MIT-HandHeldMRI/HandHeldMRI/README.md

# 64800_MRI
Designs for the 3D printed tabletop MRI for 6.4800: Biomedical Imaging with MRI

<p align="center">
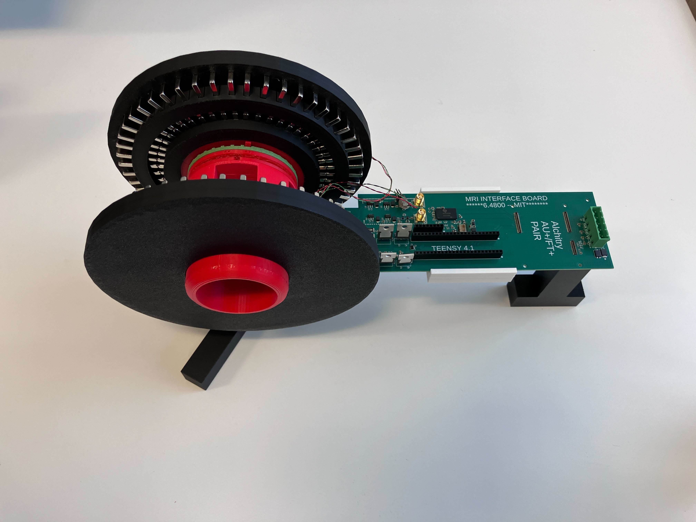
[picture p1: Images/Assembly Video/IMG_1327.jpg]
An image of an assembled MRI system
    
</p>
