MIT-HandHeldMRI/HandHeldMRI/Visualizer/vis/Uploads/d6a883e2-0e5f-45bc-9a12-a8bf46f9005b_whisk.png

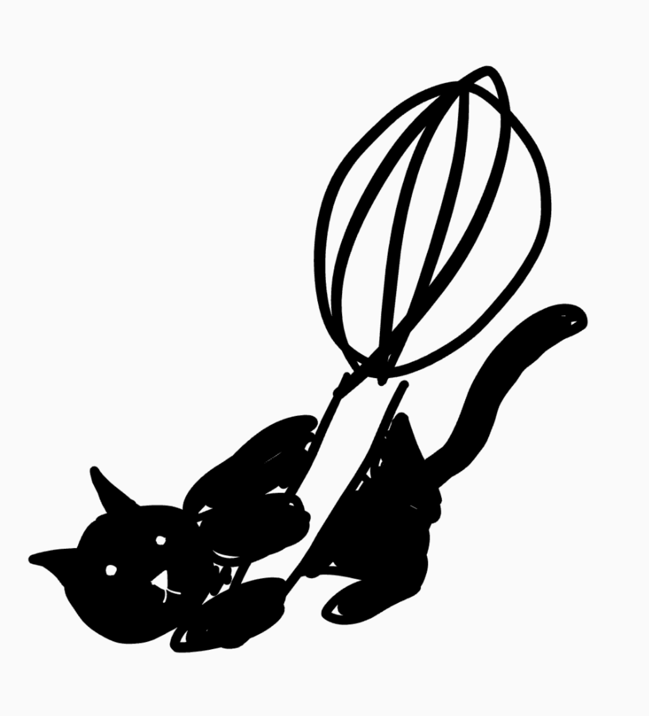
Visualizer/vis/Uploads/d6a883e2-0e5f-45bc-9a12-a8bf46f9005b_whisk.png
