MIT-HandHeldMRI/HandHeldMRI/Magnet_stl1126/mri25StandPeg.stl

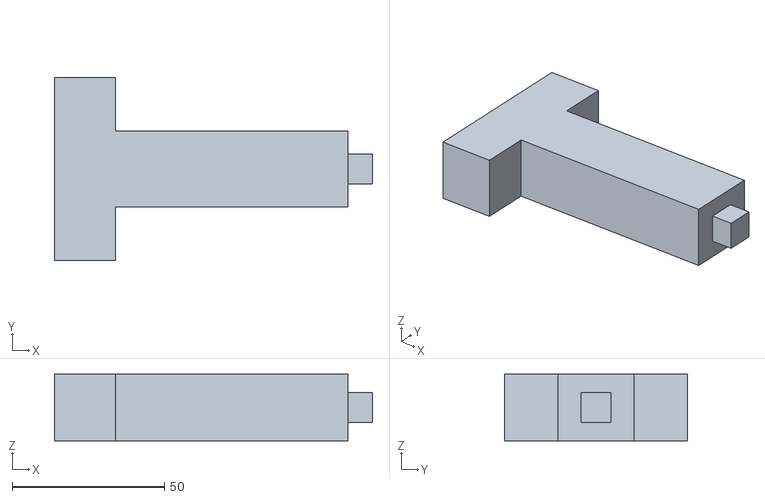
[picture p3: CAD file, 2026-11-03]
Magnet_stl1126/mri25StandPeg.stl
104.5 x 60.0 x 22.0
