MIT-HandHeldMRI/HandHeldMRI/Magnet_stl1126/mri25Cam3p28w.stl

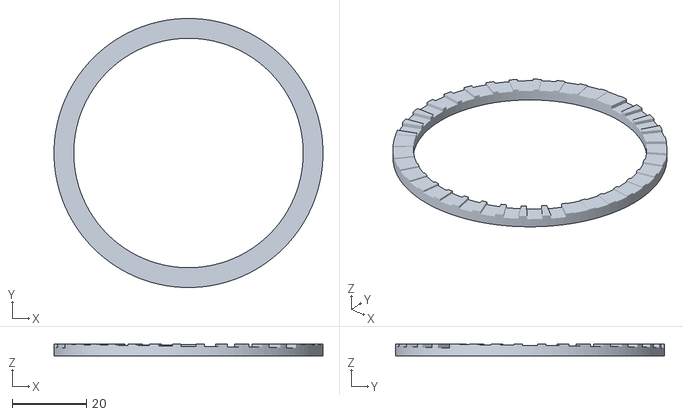
[picture p4: CAD file, 2026-11-03]
Magnet_stl1126/mri25Cam3p28w.stl
72.5 x 72.5 x 3.28
