MIT-HandHeldMRI/HandHeldMRI/Magnet_stl1126/threeSlit.stl

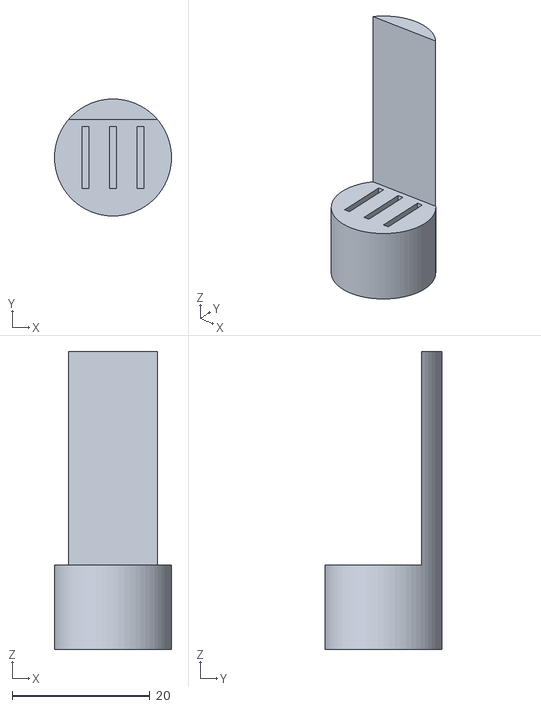
[picture p6: CAD file, 2026-11-03]
Magnet_stl1126/threeSlit.stl
17.0 x 17.0 x 43.3
