MIT-HandHeldMRI/HandHeldMRI/Magnet_stl1126/coneMRIxy.stl

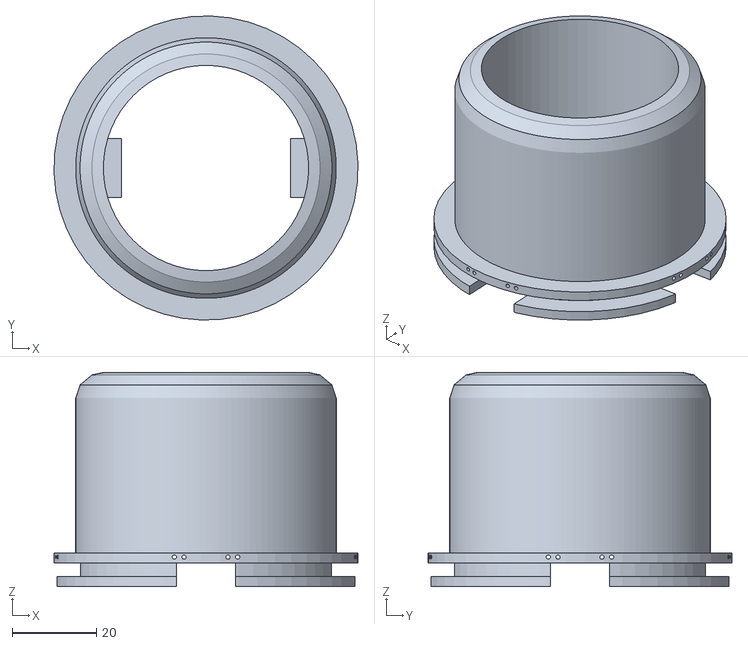
[picture p7: CAD file, 2026-11-03]
Magnet_stl1126/coneMRIxy.stl
72.0 x 72.0 x 50.7
