MIT-HandHeldMRI/HandHeldMRI/Magnet_stl1126/standxy.stl

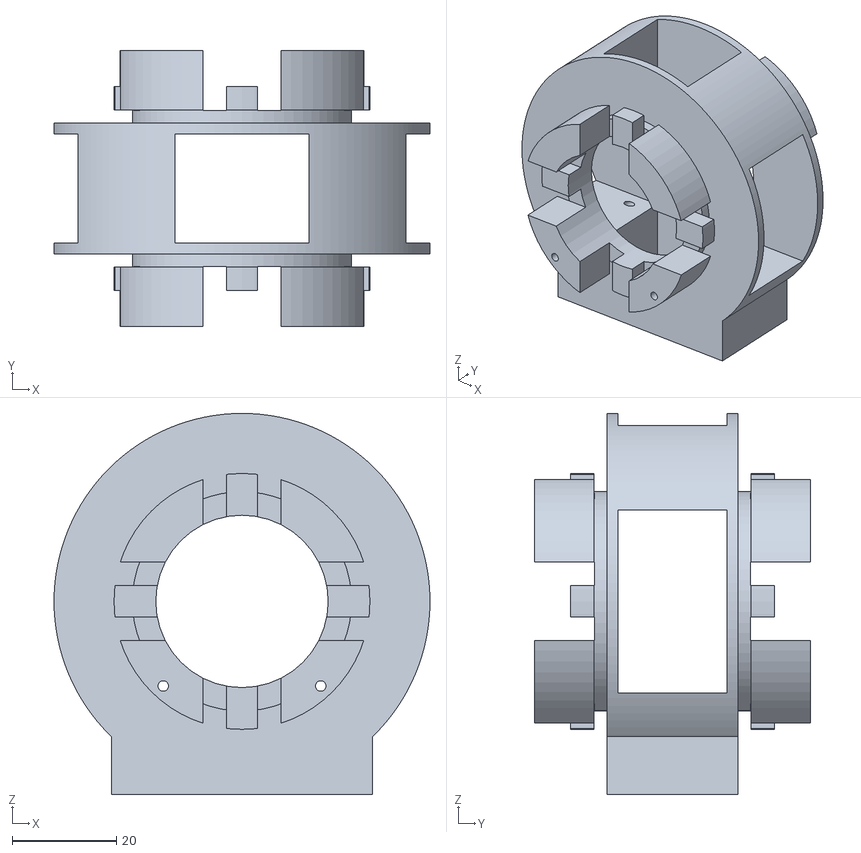
[picture p8: CAD file, 2026-11-03]
Magnet_stl1126/standxy.stl
72.0 x 52.9 x 73.0
