MIT-HandHeldMRI/HandHeldMRI/Magnet_stl1126/space17p5.stl

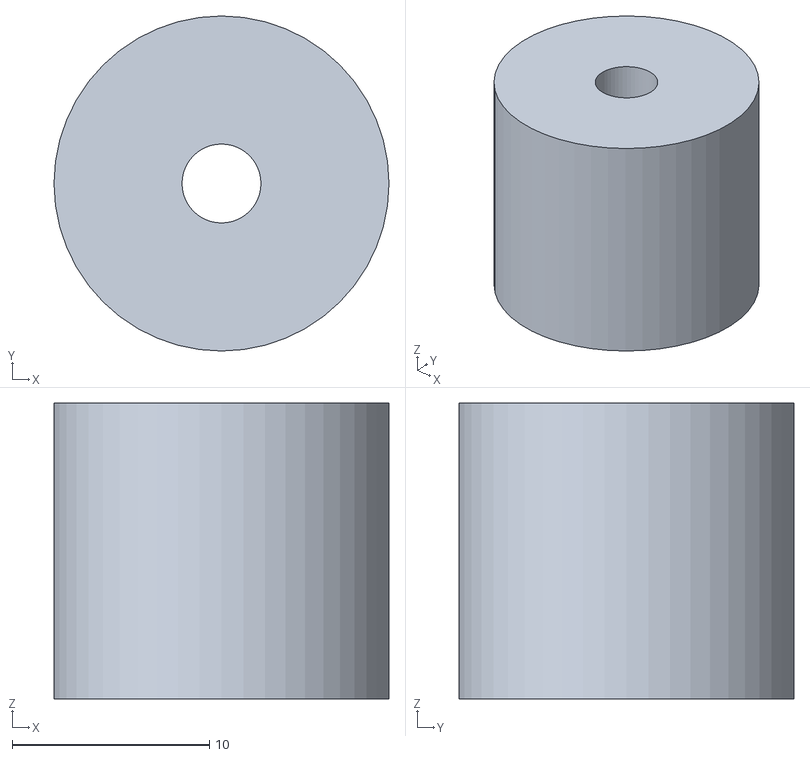
[picture p9: CAD file, 2026-11-03]
Magnet_stl1126/space17p5.stl
17.0 x 17.0 x 15.0
