MIT-HandHeldMRI/HandHeldMRI/Magnet_stl1126/mri25Cam4p22w.stl

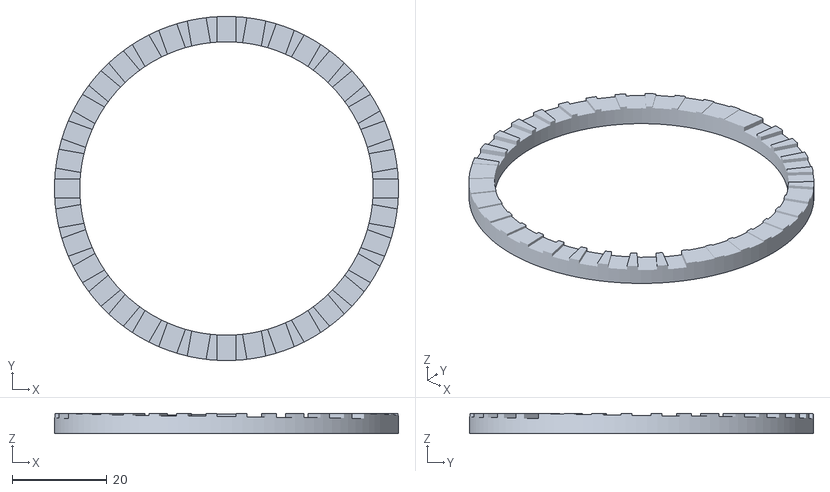
[picture p10: CAD file, 2026-11-03]
Magnet_stl1126/mri25Cam4p22w.stl
72.5 x 72.5 x 4.22
