MIT-HandHeldMRI/HandHeldMRI/Magnet_stl1126/mri25MagRing.stl

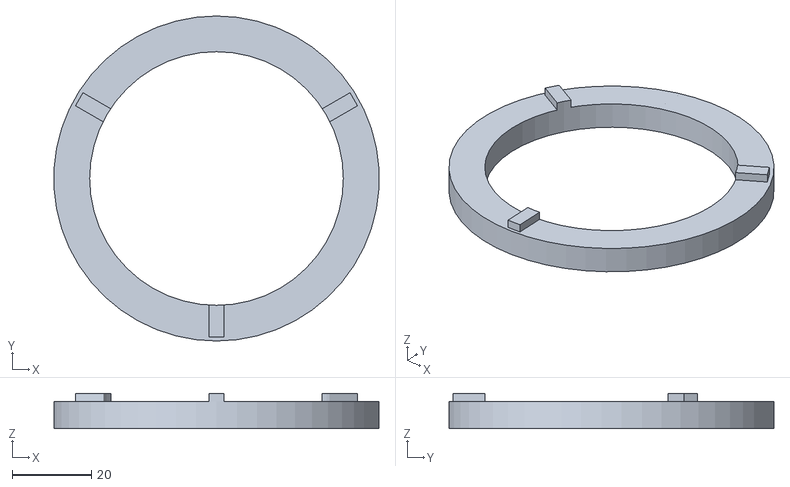
[picture p11: CAD file, 2026-11-03]
Magnet_stl1126/mri25MagRing.stl
82.0 x 82.0 x 8.90
