MIT-HandHeldMRI/HandHeldMRI/Magnet_stl1126/mri25_10x10x10.stl

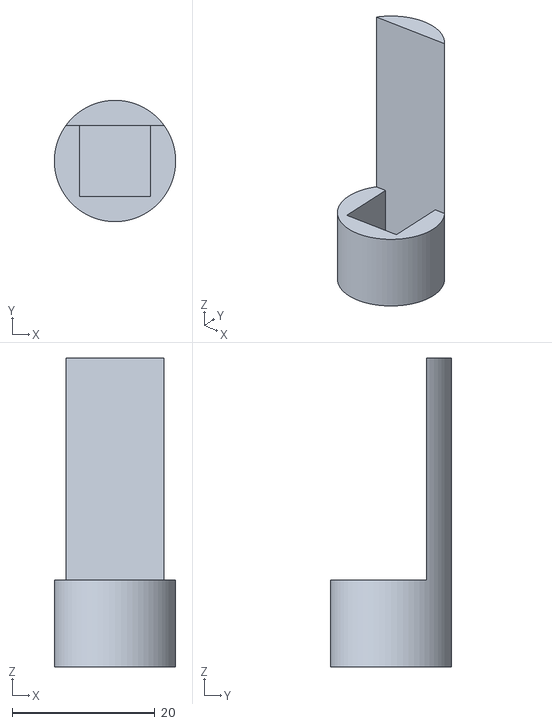
[picture p12: CAD file, 2026-11-03]
Magnet_stl1126/mri25_10x10x10.stl
17.0 x 17.0 x 43.3
