MIT-HandHeldMRI/HandHeldMRI/Magnet_stl1126/mri26SupportPlate.stl

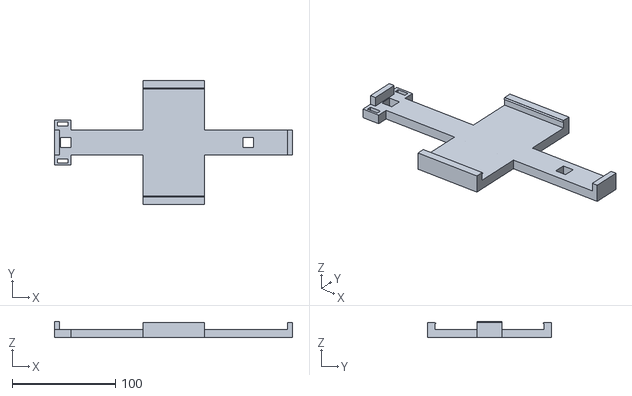
[picture p13: CAD file, 2026-11-03]
Magnet_stl1126/mri26SupportPlate.stl
231.0 x 120.0 x 16.0
