MIT-HandHeldMRI/HandHeldMRI/Magnet_stl1126/mri25threeSlice.stl

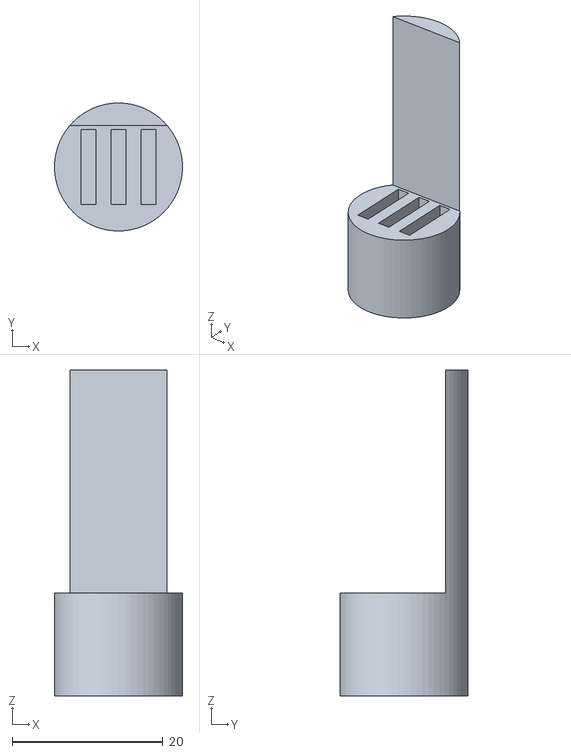
[picture p14: CAD file, 2026-11-03]
Magnet_stl1126/mri25threeSlice.stl
17.0 x 17.0 x 43.3
