MIT-HandHeldMRI/HandHeldMRI/Magnet_stl1126/mri25RfCoilForm.stl

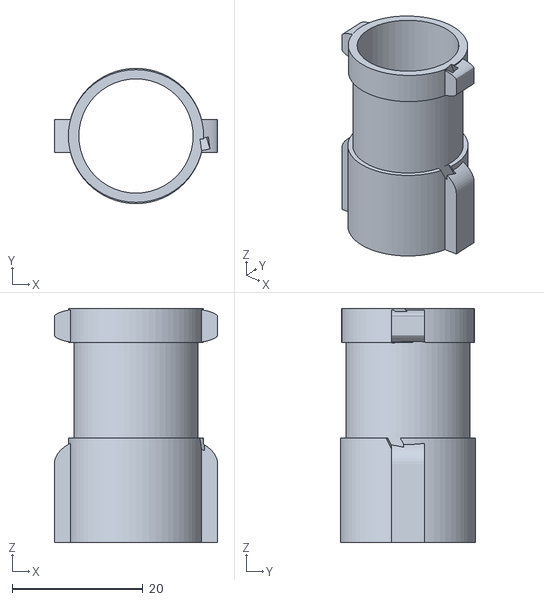
[picture p15: CAD file, 2026-11-03]
Magnet_stl1126/mri25RfCoilForm.stl
25.0 x 20.7 x 35.8
