MIT-HandHeldMRI/HandHeldMRI/Magnet_stl1126/pusher.stl

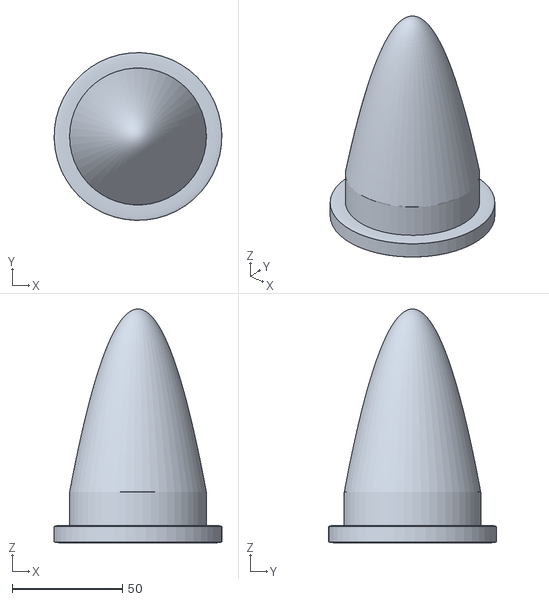
[picture p16: CAD file, 2026-11-03]
Magnet_stl1126/pusher.stl
76.0 x 76.0 x 106.0
