MIT-HandHeldMRI/HandHeldMRI/Magnet_stl1126/mri25Stand.stl

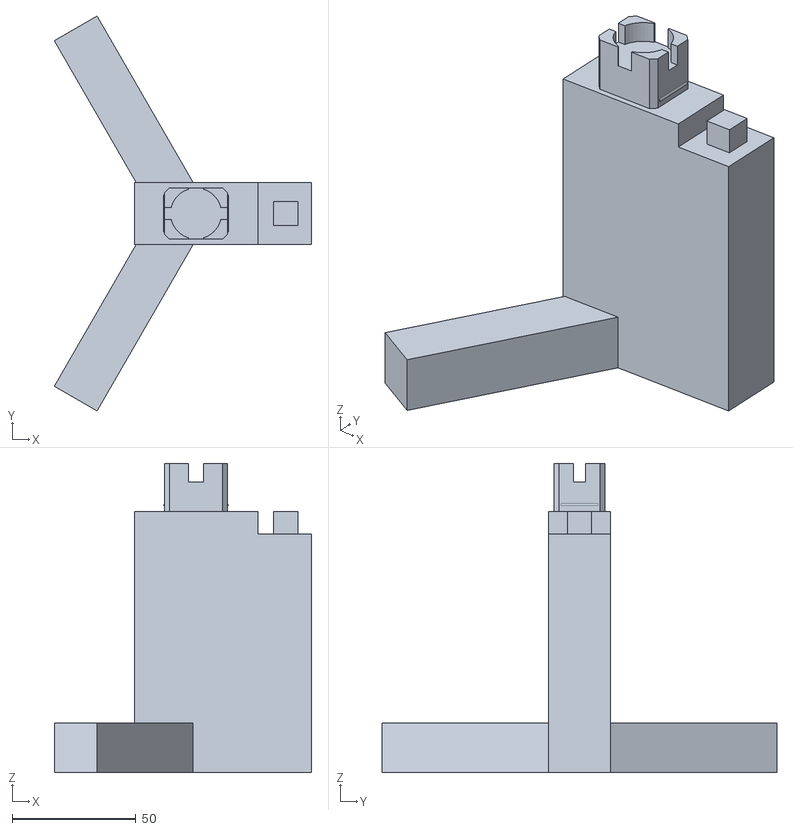
[picture p17: CAD file, 2026-11-03]
Magnet_stl1126/mri25Stand.stl
104.2 x 159.9 x 125.1
