MIT-HandHeldMRI/HandHeldMRI/Magnet_stl1126/mri25Spacer.stl

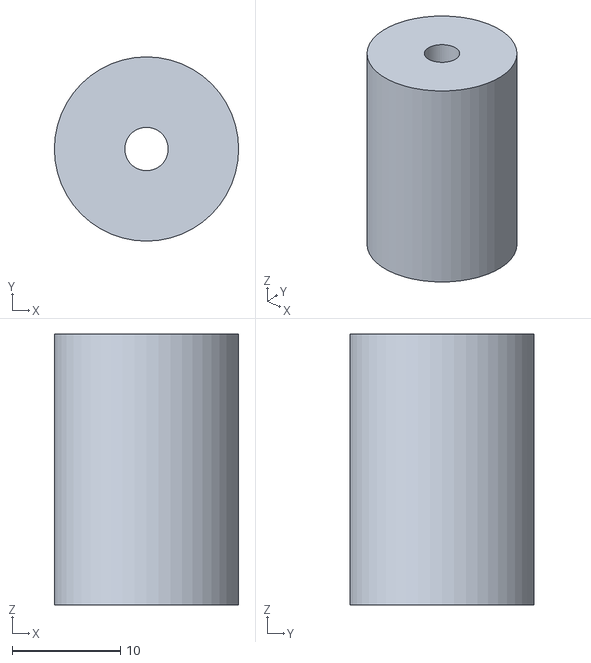
[picture p18: CAD file, 2026-11-03]
Magnet_stl1126/mri25Spacer.stl
17.0 x 17.0 x 25.0
