MIT-HandHeldMRI/HandHeldMRI/Magnet_stl1126/magRing.stl

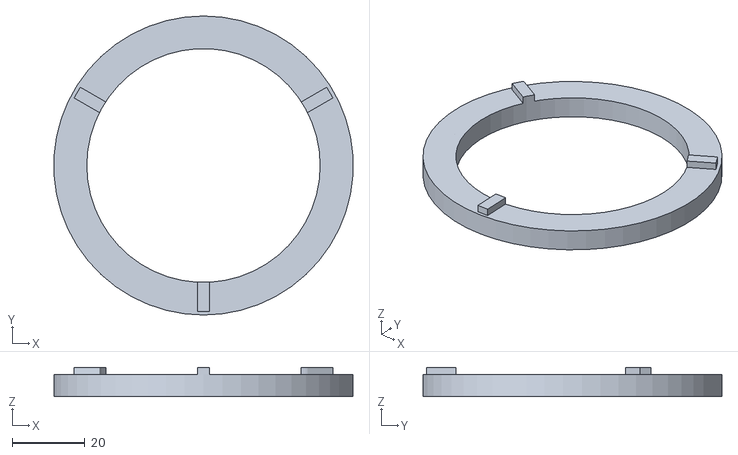
[picture p19: CAD file, 2026-11-03]
Magnet_stl1126/magRing.stl
82.0 x 82.0 x 8.00
