MIT-HandHeldMRI/HandHeldMRI/Magnet_stl1126/mri25MagHolder.stl

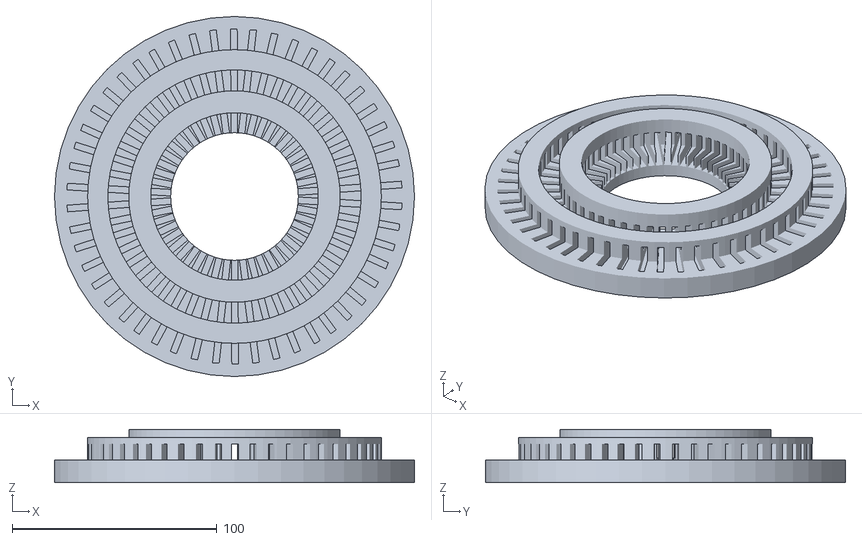
[picture p20: CAD file, 2026-11-03]
Magnet_stl1126/mri25MagHolder.stl
176.0 x 176.0 x 26.0
