MIT-HandHeldMRI/HandHeldMRI/Magnet_stl1126/mri25cam3p6.stl

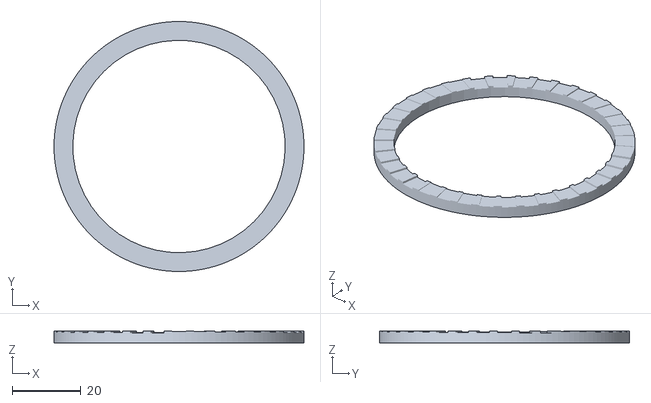
[picture p21: CAD file, 2026-11-03]
Magnet_stl1126/mri25cam3p6.stl
72.8 x 72.8 x 3.60
