MIT-HandHeldMRI/HandHeldMRI/(list of files, cad)

Other CAD files:
Images/Assembly Video/assembly.blend
