MIT-HandHeldMRI/HandHeldMRI/Images/Assembly Video/IMG_1287.jpg

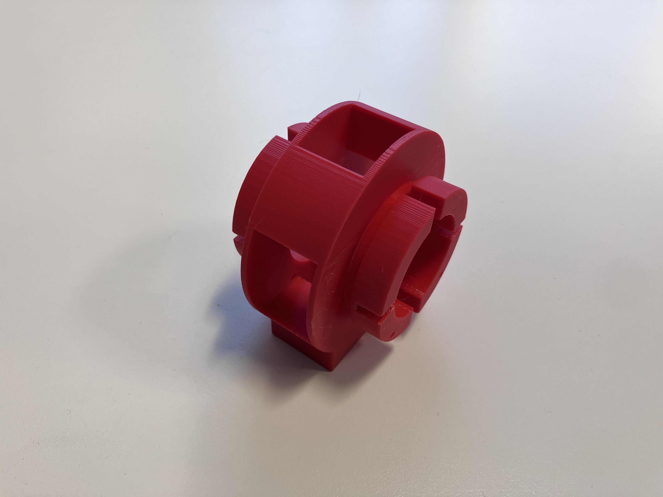
Images/Assembly Video/IMG_1287.jpg
