MIT-HandHeldMRI/HandHeldMRI/Images/Assembly Video/IMG_1288.jpg

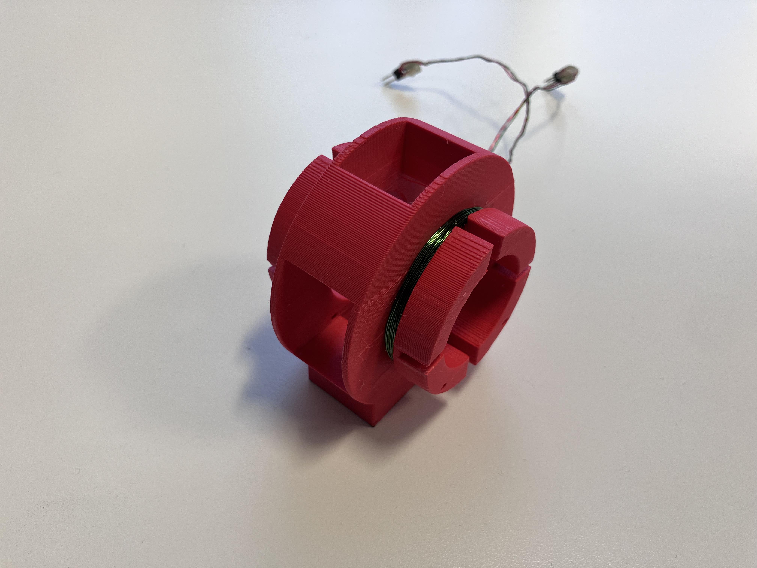
Images/Assembly Video/IMG_1288.jpg
