MIT-HandHeldMRI/HandHeldMRI/Images/Assembly Video/IMG_1291.jpg

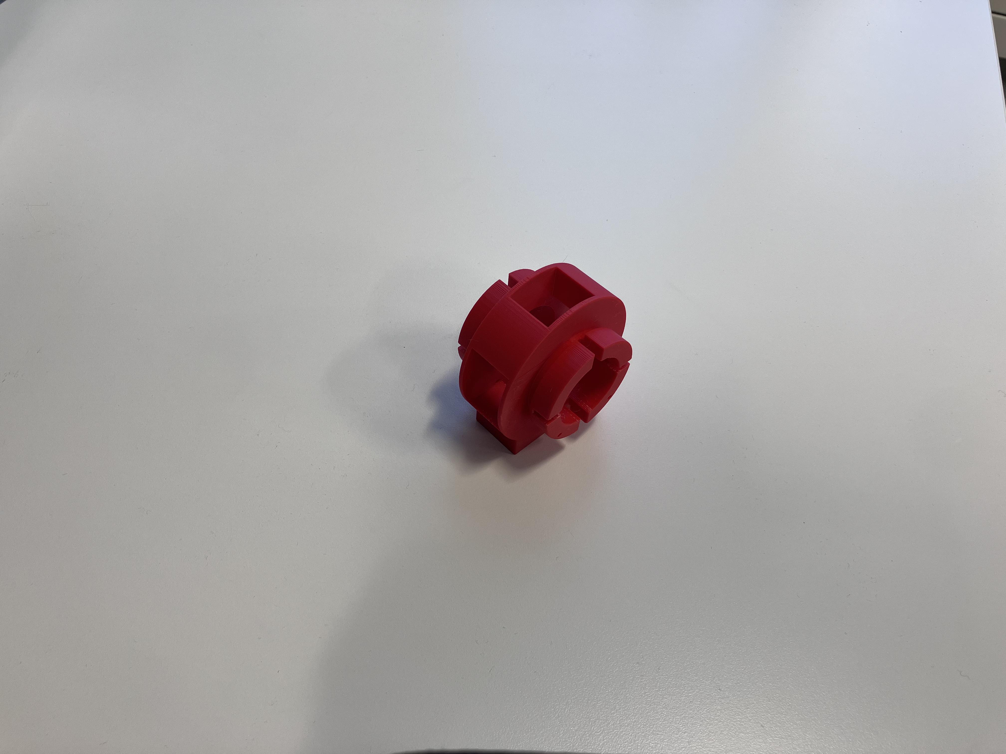
Images/Assembly Video/IMG_1291.jpg
