MIT-HandHeldMRI/HandHeldMRI/Images/Assembly Video/IMG_1292.jpg

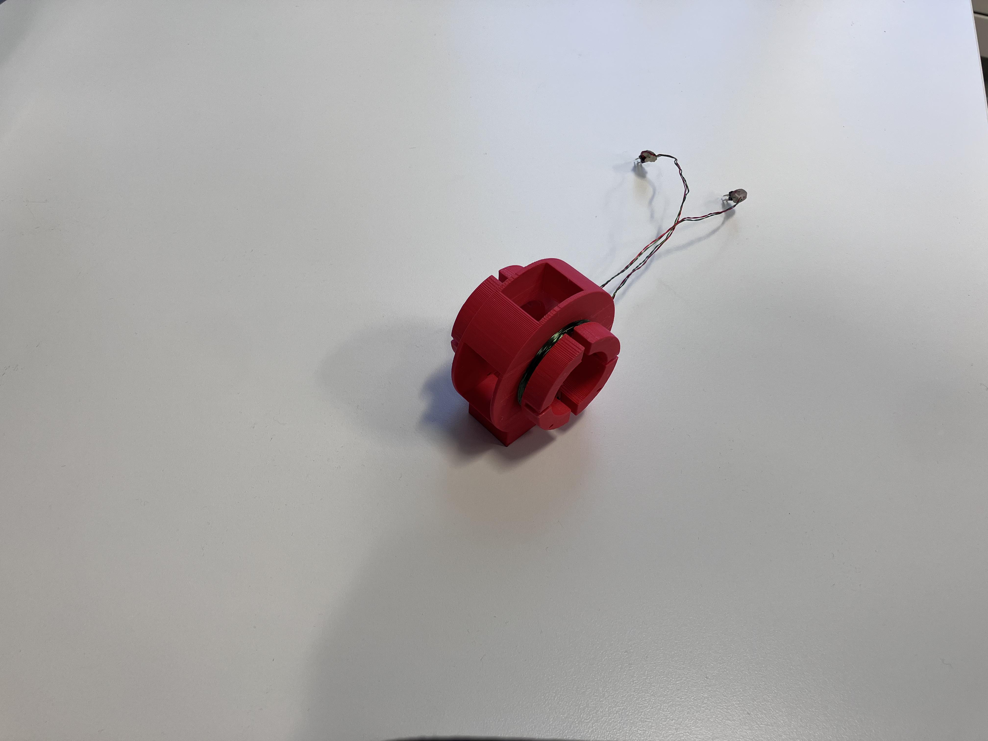
Images/Assembly Video/IMG_1292.jpg
