MIT-HandHeldMRI/HandHeldMRI/Images/Assembly Video/IMG_1293.jpg

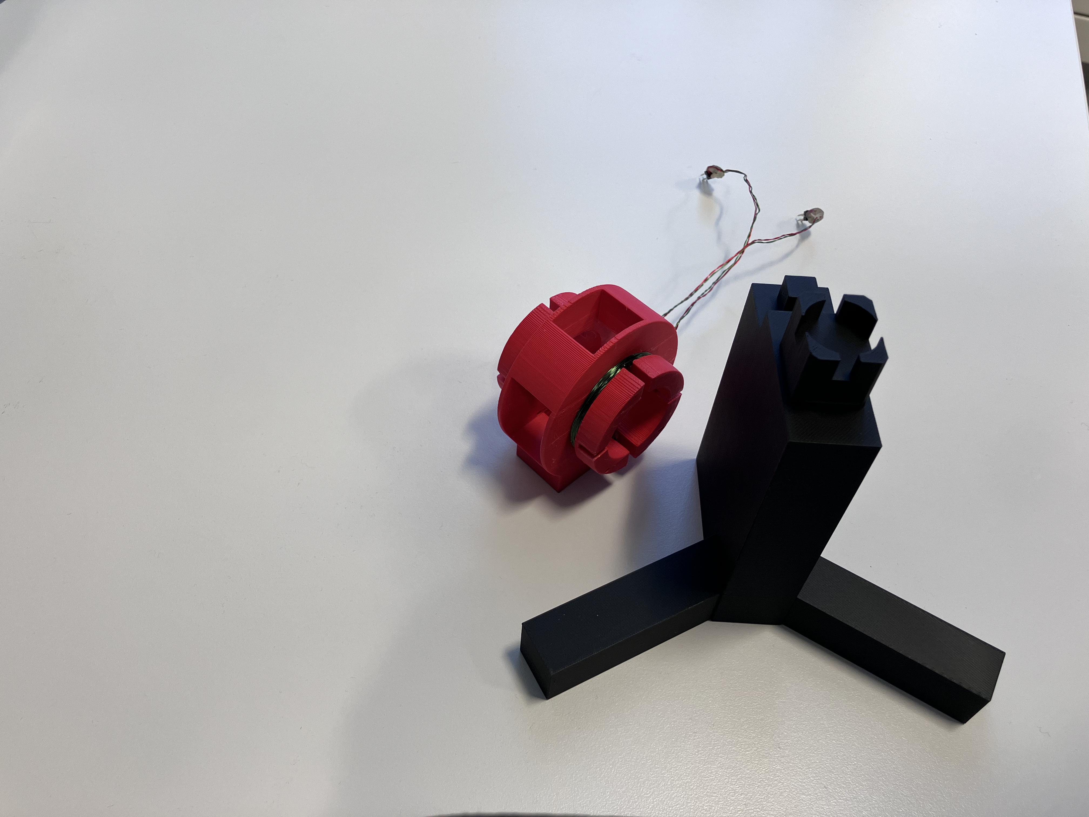
Images/Assembly Video/IMG_1293.jpg
