MIT-HandHeldMRI/HandHeldMRI/Images/Assembly Video/IMG_1294.jpg

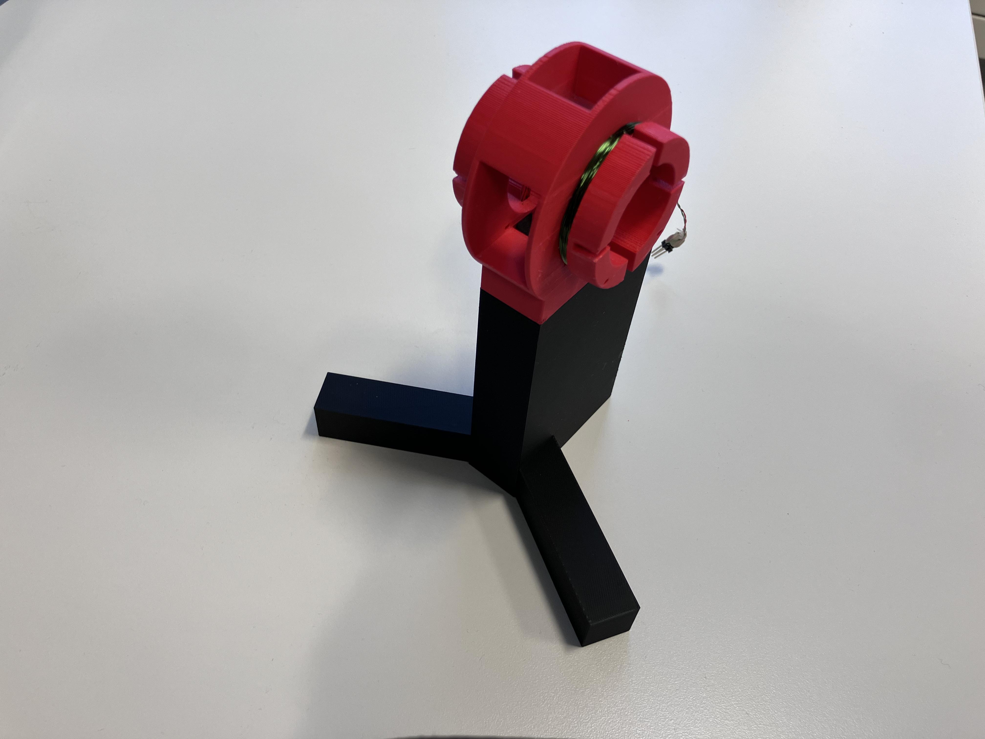
Images/Assembly Video/IMG_1294.jpg
