MIT-HandHeldMRI/HandHeldMRI/Images/Assembly Video/IMG_1295.jpg

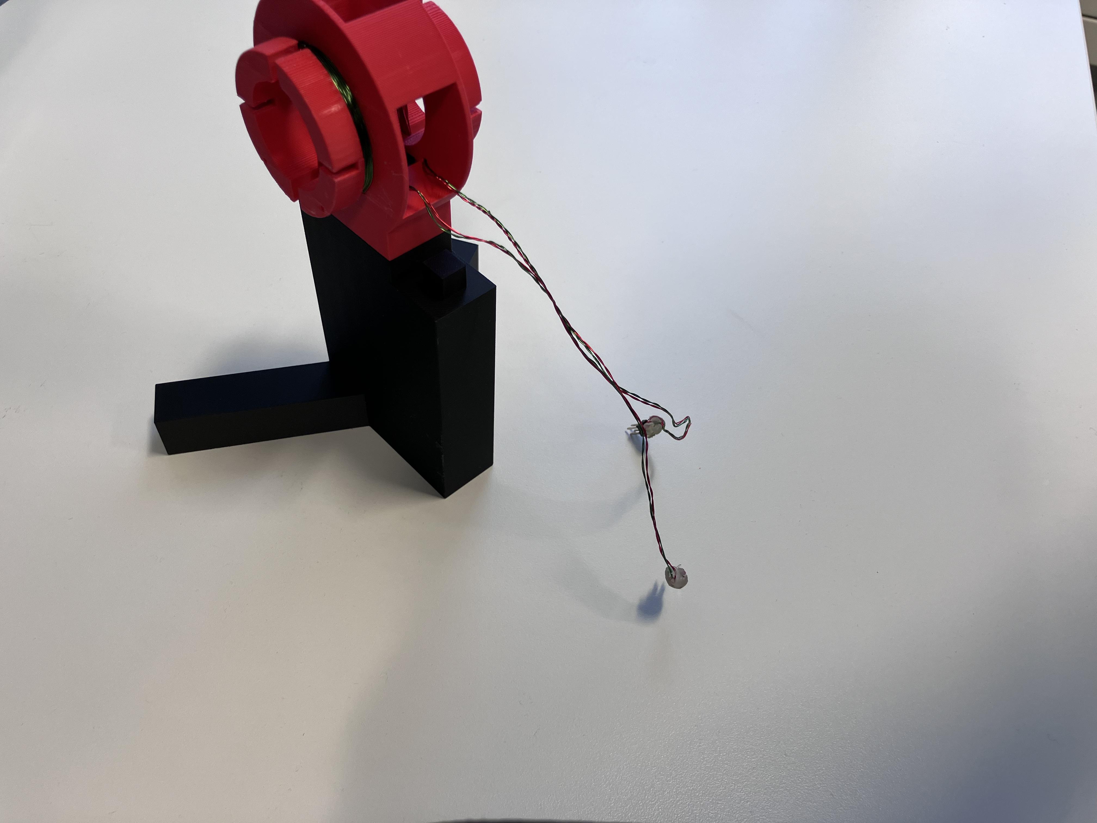
Images/Assembly Video/IMG_1295.jpg
