MIT-HandHeldMRI/HandHeldMRI/Images/Assembly Video/IMG_1296.jpg

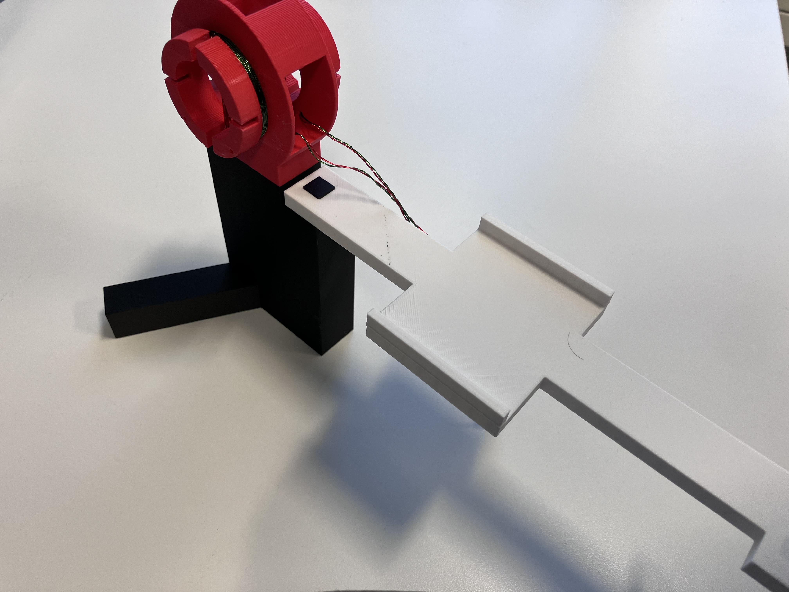
Images/Assembly Video/IMG_1296.jpg
