MIT-HandHeldMRI/HandHeldMRI/Images/Assembly Video/IMG_1297.jpg

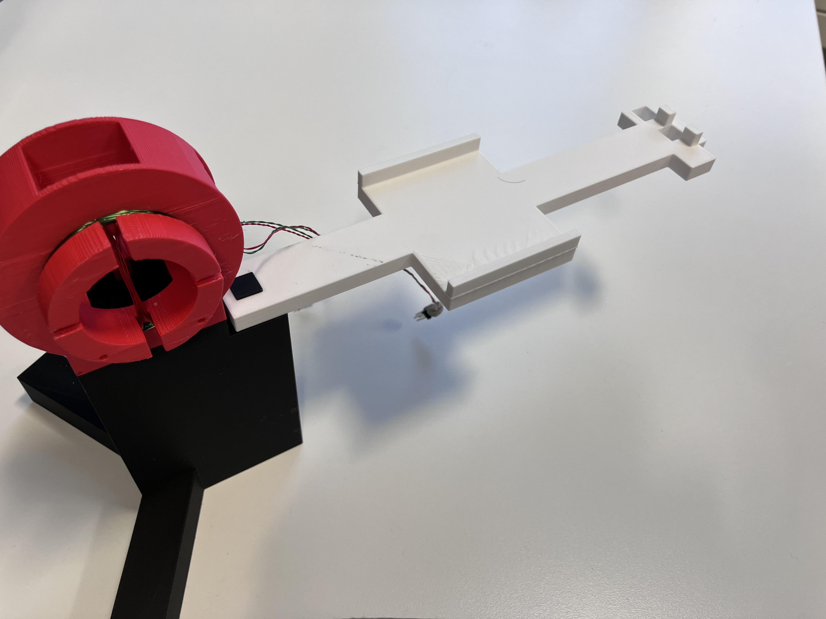
Images/Assembly Video/IMG_1297.jpg
