MIT-HandHeldMRI/HandHeldMRI/Images/Assembly Video/IMG_1298.jpg

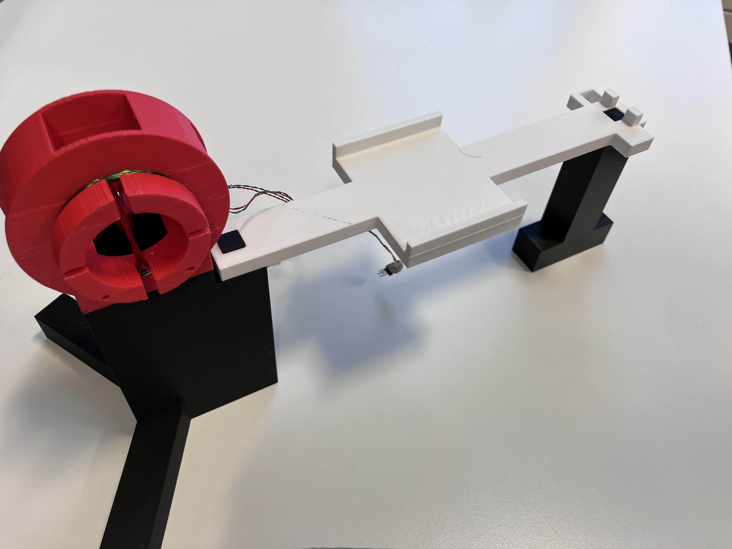
Images/Assembly Video/IMG_1298.jpg
