MIT-HandHeldMRI/HandHeldMRI/Images/Assembly Video/IMG_1299.jpg

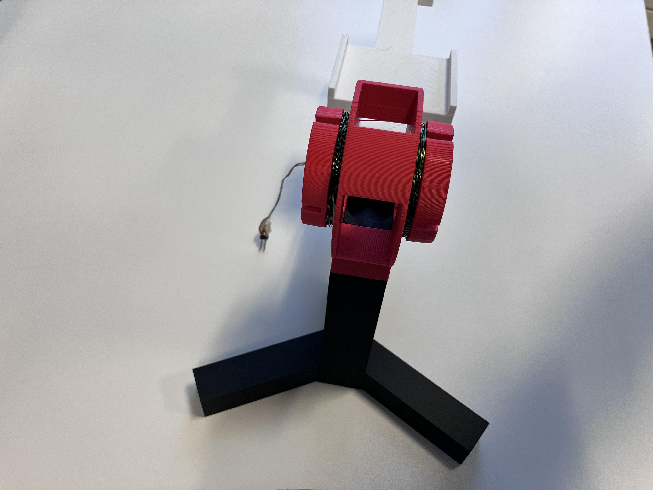
Images/Assembly Video/IMG_1299.jpg
