MIT-HandHeldMRI/HandHeldMRI/Images/Assembly Video/IMG_1300.jpg

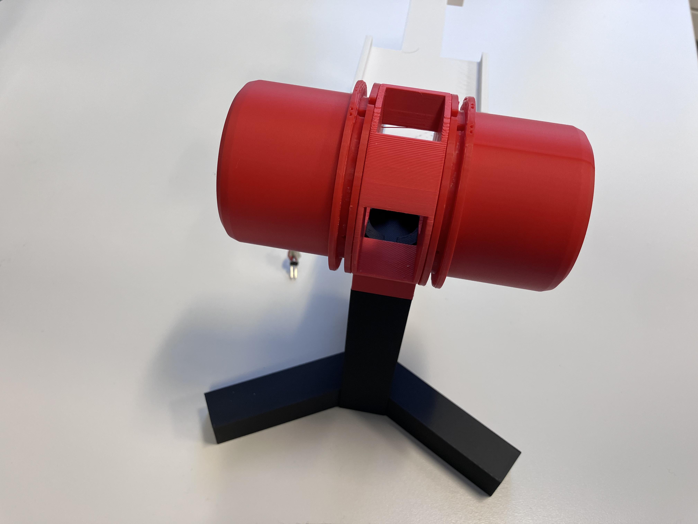
Images/Assembly Video/IMG_1300.jpg
