MIT-HandHeldMRI/HandHeldMRI/Images/Assembly Video/IMG_1301.jpg

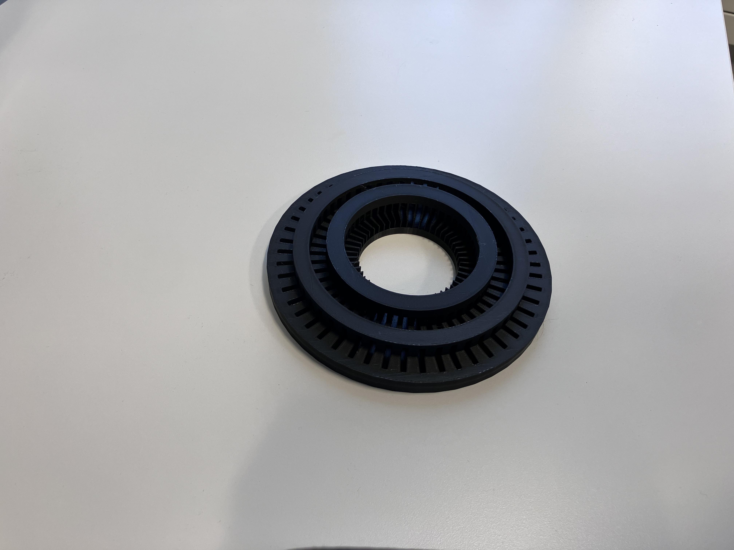
Images/Assembly Video/IMG_1301.jpg
