MIT-HandHeldMRI/HandHeldMRI/Images/Assembly Video/IMG_1303.jpg

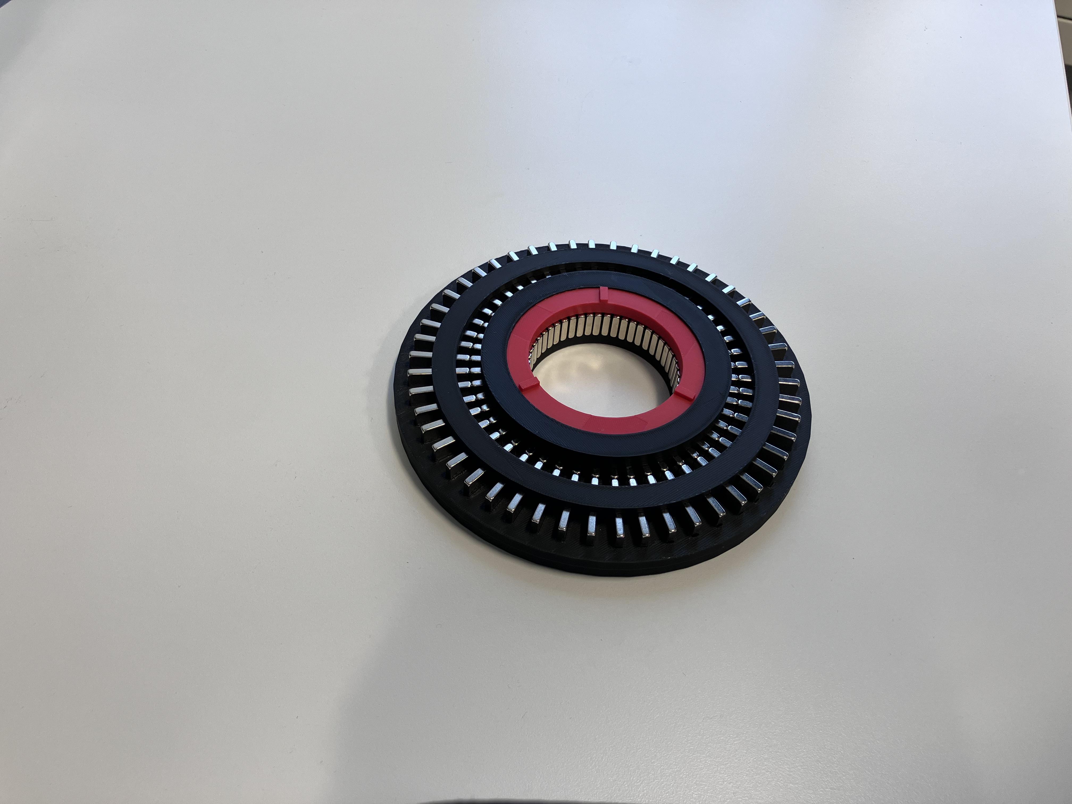
Images/Assembly Video/IMG_1303.jpg
