MIT-HandHeldMRI/HandHeldMRI/Images/Assembly Video/IMG_1304.jpg

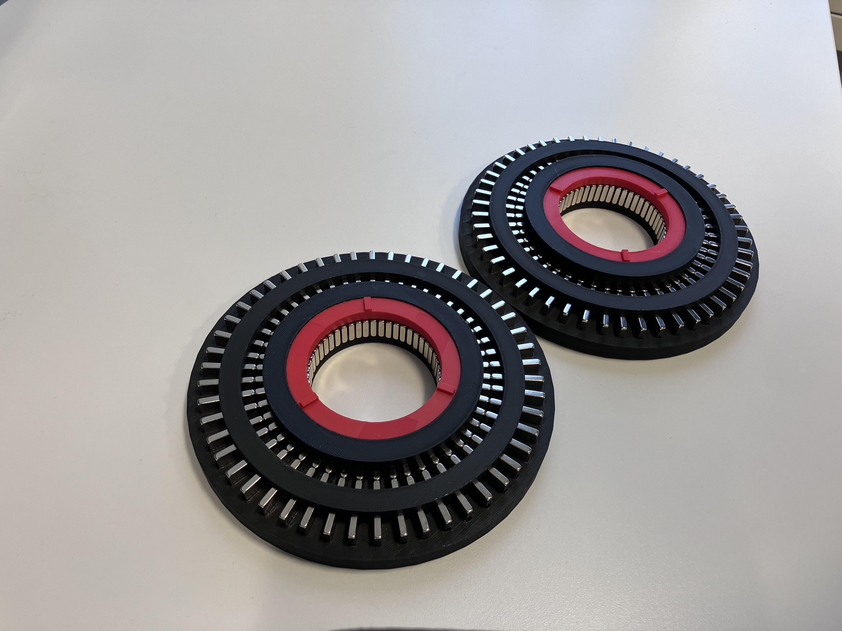
Images/Assembly Video/IMG_1304.jpg
