MIT-HandHeldMRI/HandHeldMRI/Images/Assembly Video/IMG_1305.jpg

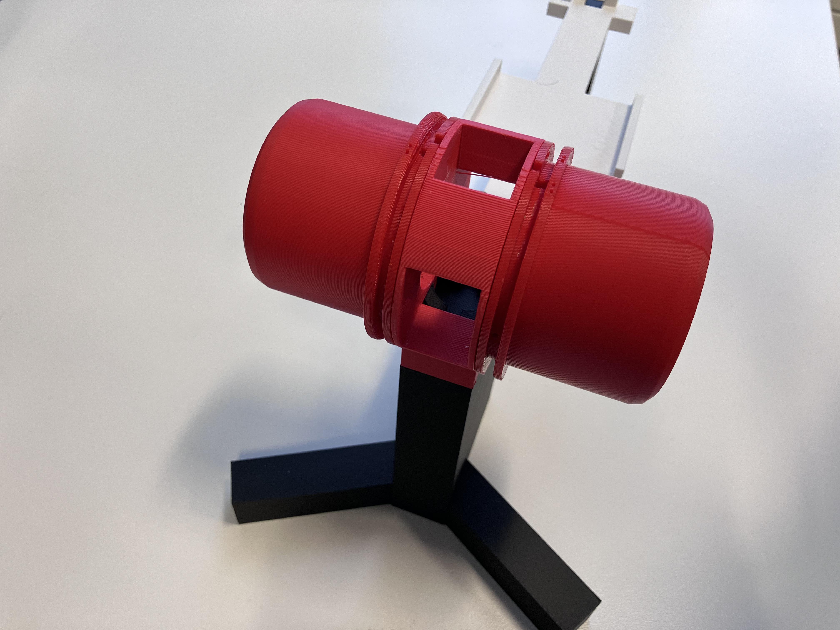
Images/Assembly Video/IMG_1305.jpg
