MIT-HandHeldMRI/HandHeldMRI/Images/Assembly Video/IMG_1308.jpg

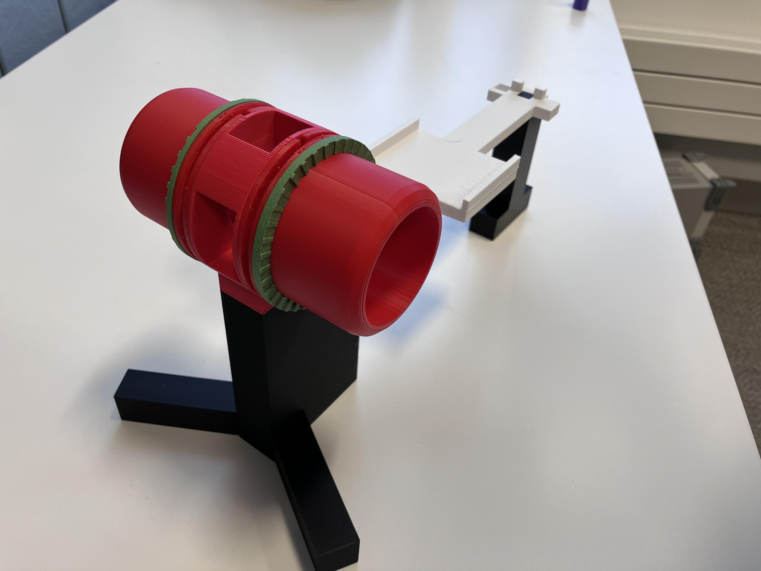
Images/Assembly Video/IMG_1308.jpg
