MIT-HandHeldMRI/HandHeldMRI/Images/Assembly Video/IMG_1309.jpg

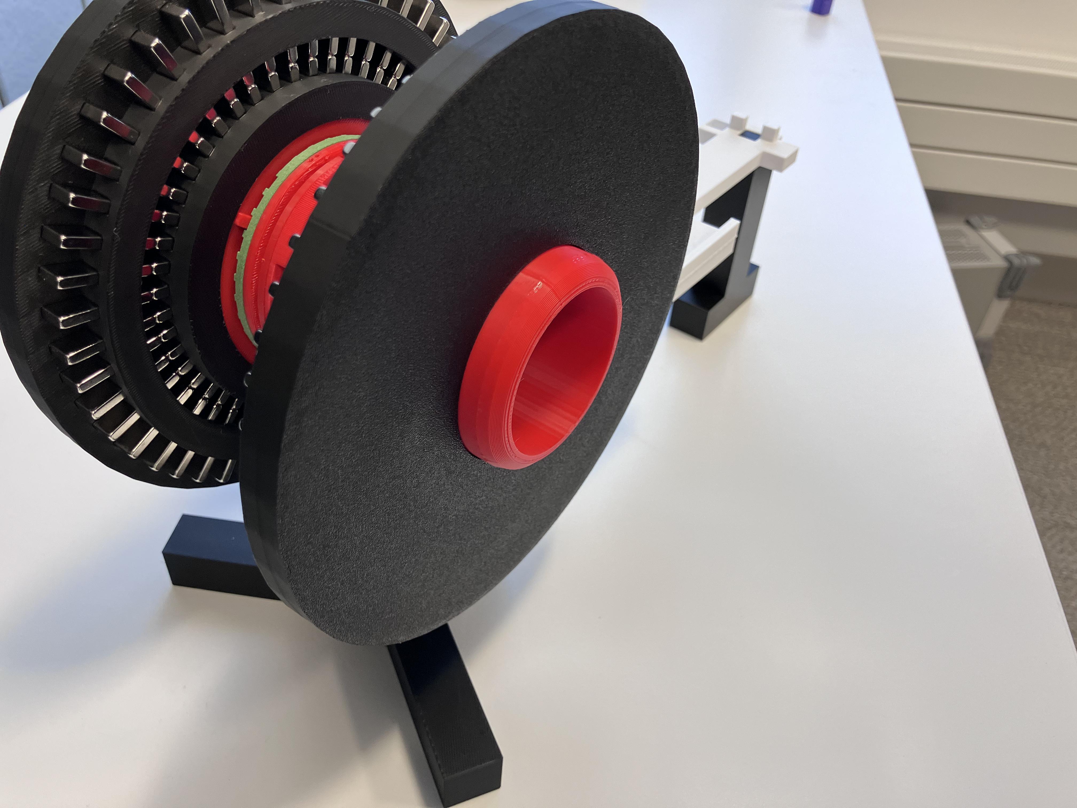
Images/Assembly Video/IMG_1309.jpg
