MIT-HandHeldMRI/HandHeldMRI/Images/Assembly Video/IMG_1310.jpg

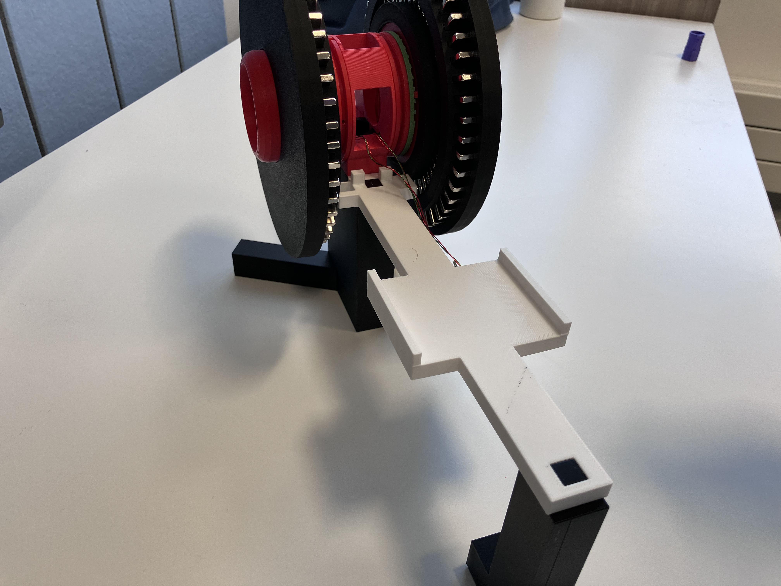
Images/Assembly Video/IMG_1310.jpg
