MIT-HandHeldMRI/HandHeldMRI/Images/Assembly Video/IMG_1311.jpg

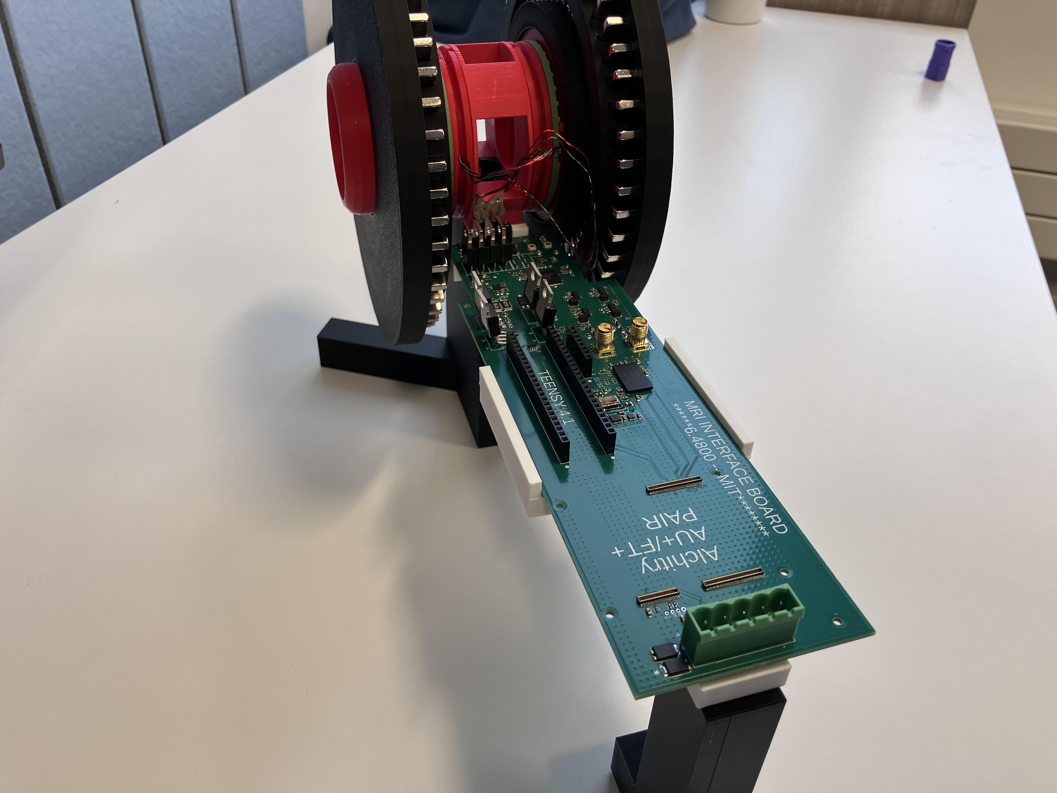
Images/Assembly Video/IMG_1311.jpg
