MIT-HandHeldMRI/HandHeldMRI/Images/Assembly Video/IMG_1312.jpg

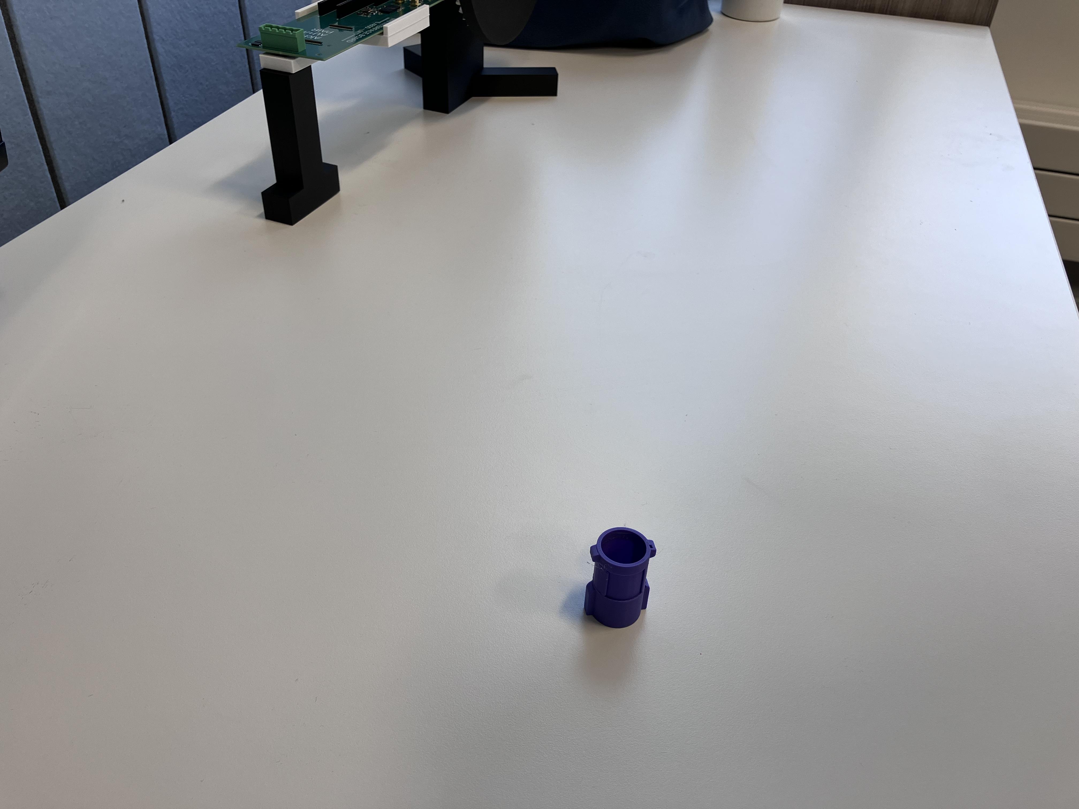
Images/Assembly Video/IMG_1312.jpg
