MIT-HandHeldMRI/HandHeldMRI/Images/Assembly Video/IMG_1313.jpg

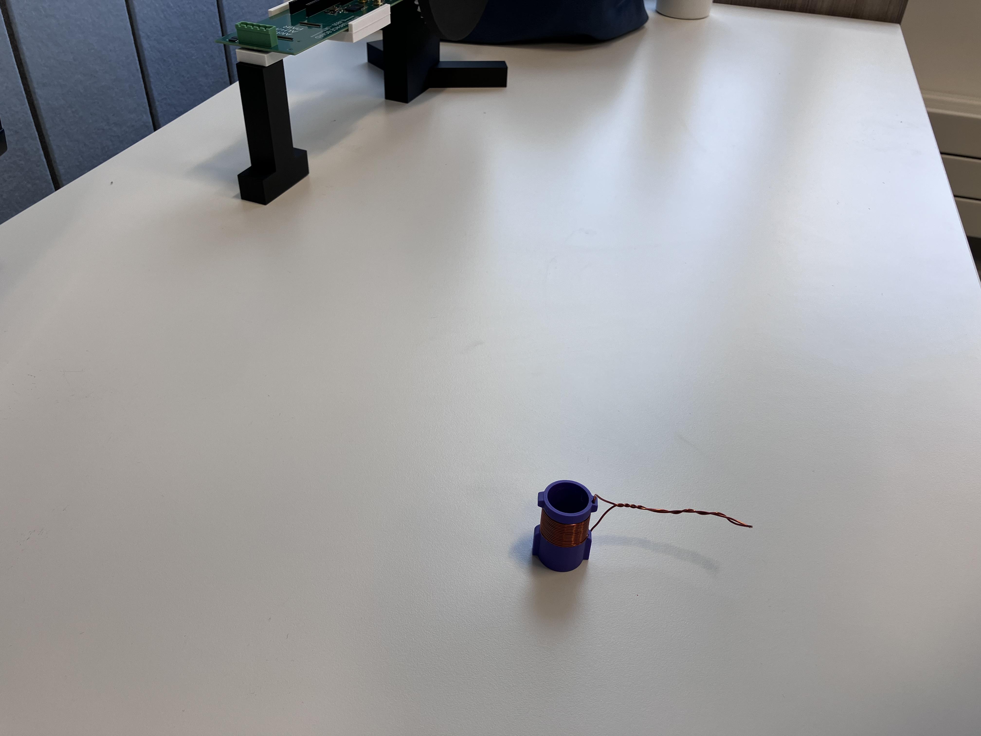
Images/Assembly Video/IMG_1313.jpg
