MIT-HandHeldMRI/HandHeldMRI/Images/Assembly Video/IMG_1314.jpg

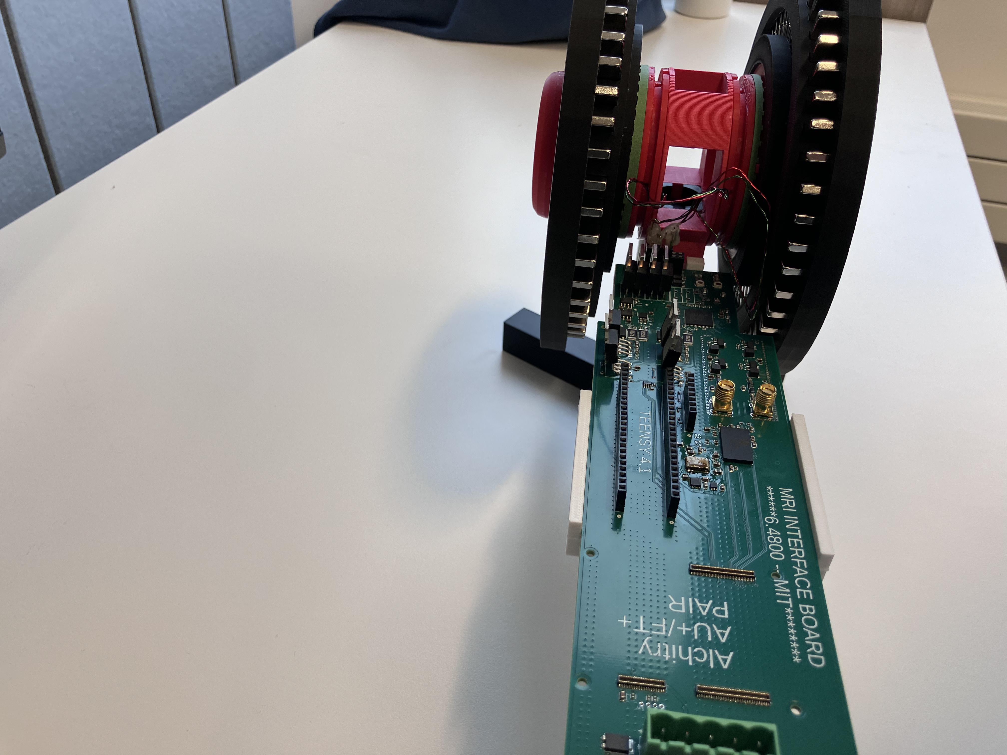
Images/Assembly Video/IMG_1314.jpg
