MIT-HandHeldMRI/HandHeldMRI/Images/Assembly Video/IMG_1316.jpg

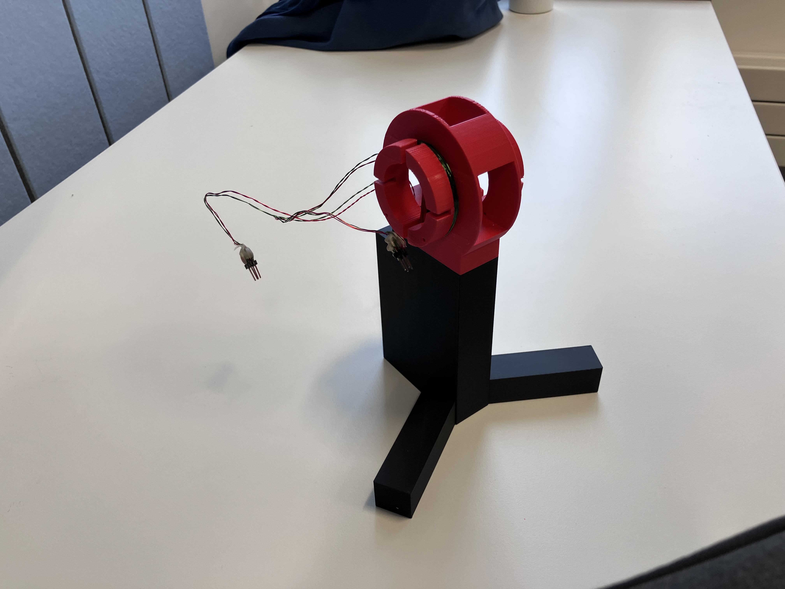
Images/Assembly Video/IMG_1316.jpg
