MIT-HandHeldMRI/HandHeldMRI/Images/Assembly Video/IMG_1317.jpg

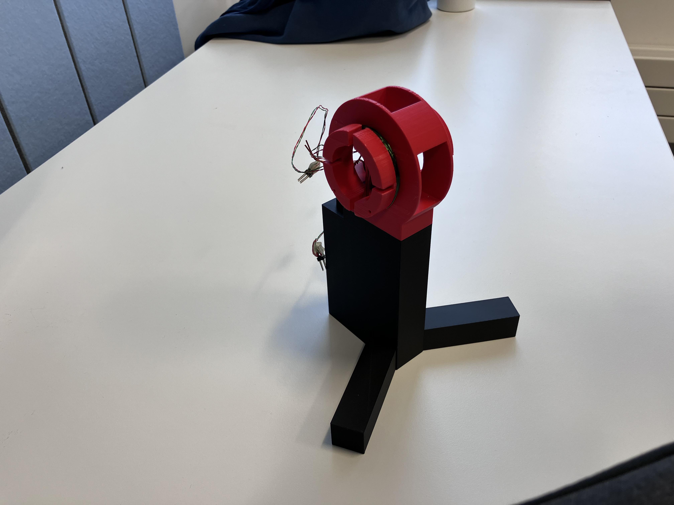
Images/Assembly Video/IMG_1317.jpg
