MIT-HandHeldMRI/HandHeldMRI/Images/Assembly Video/IMG_1318.jpg

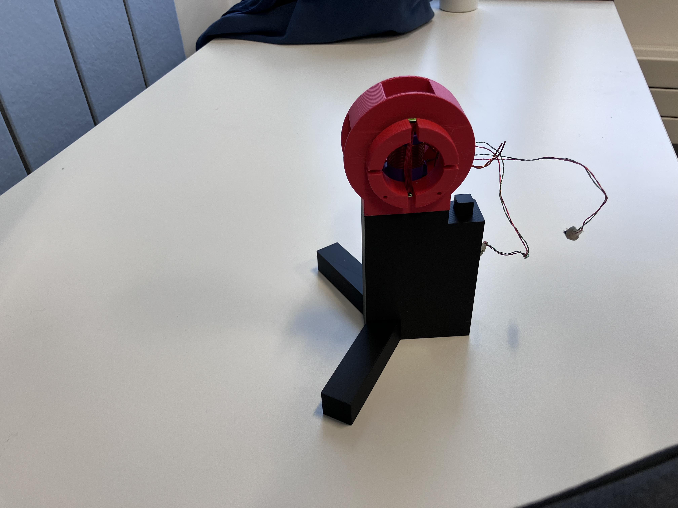
Images/Assembly Video/IMG_1318.jpg
