MIT-HandHeldMRI/HandHeldMRI/Images/Assembly Video/IMG_1319.jpg

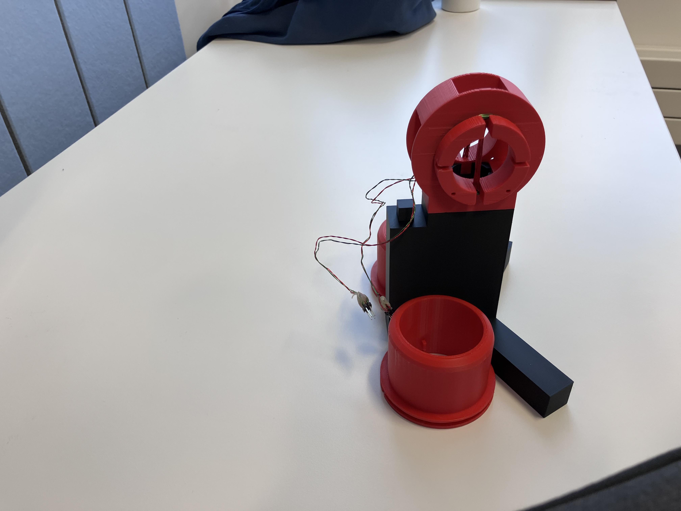
Images/Assembly Video/IMG_1319.jpg
