MIT-HandHeldMRI/HandHeldMRI/Images/Assembly Video/IMG_1320.jpg

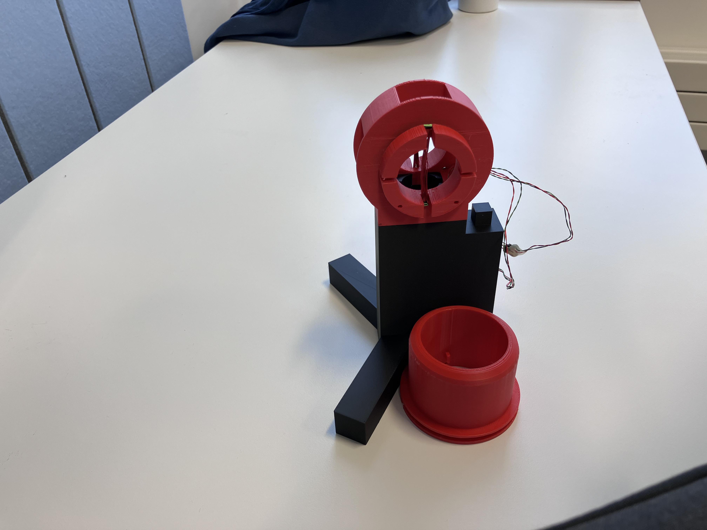
Images/Assembly Video/IMG_1320.jpg
