MIT-HandHeldMRI/HandHeldMRI/Images/Assembly Video/IMG_1321.jpg

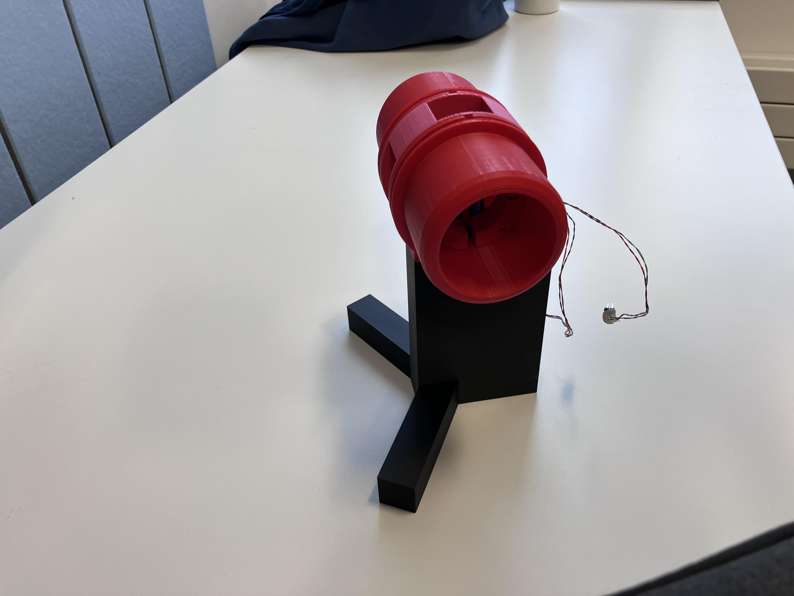
Images/Assembly Video/IMG_1321.jpg
