MIT-HandHeldMRI/HandHeldMRI/Images/Assembly Video/IMG_1322.jpg

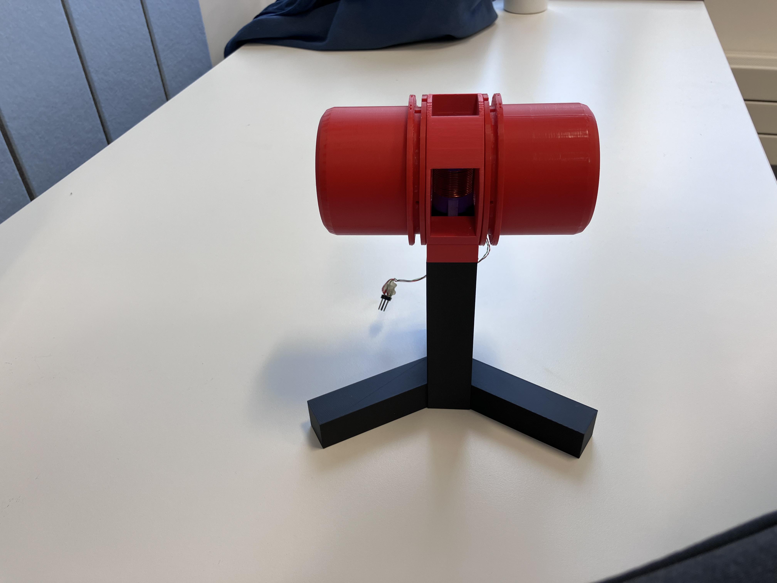
Images/Assembly Video/IMG_1322.jpg
