MIT-HandHeldMRI/HandHeldMRI/Images/Assembly Video/IMG_1324.jpg

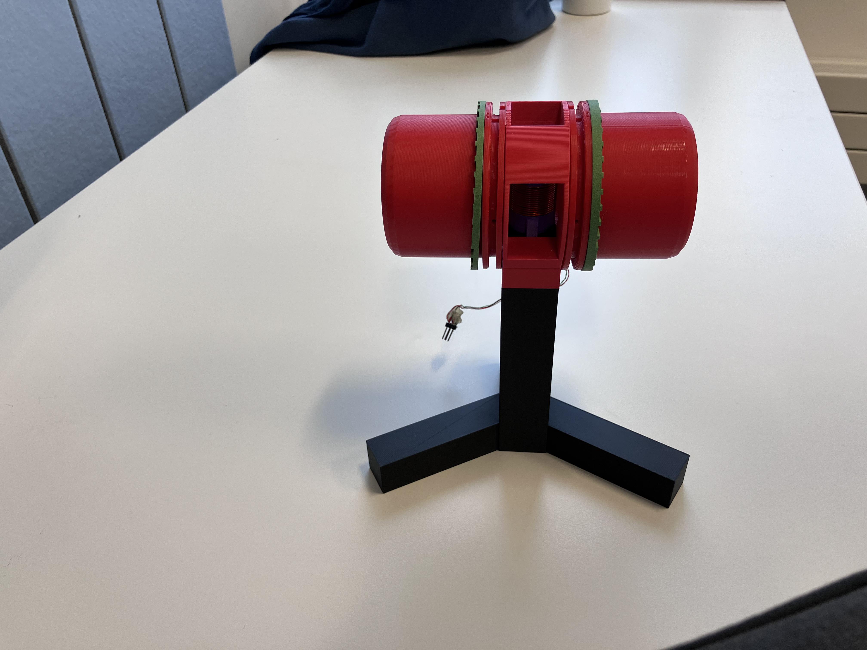
Images/Assembly Video/IMG_1324.jpg
