MIT-HandHeldMRI/HandHeldMRI/Images/Assembly Video/IMG_1325.jpg

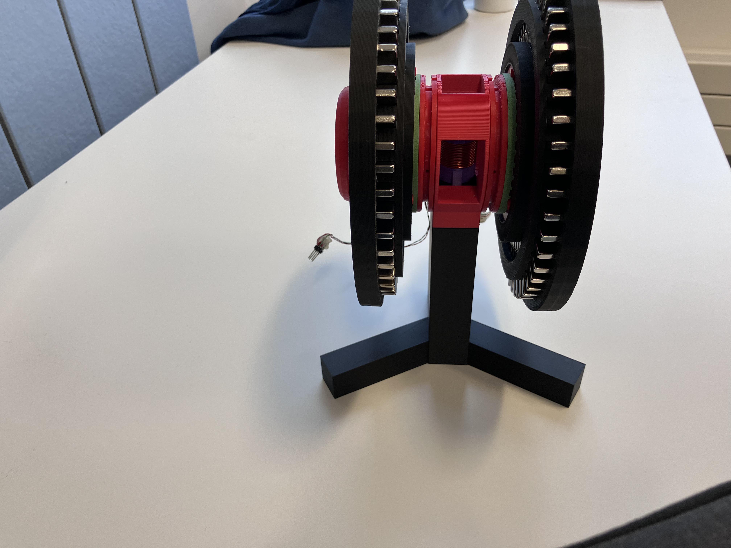
Images/Assembly Video/IMG_1325.jpg
