MIT-HandHeldMRI/HandHeldMRI/Electronics/newMRI_26_08P/newMRI_26_08A.kicad_pcb

## KiCad design Electronics/newMRI_26_08P/newMRI_26_08A.kicad_pcb (2026-10-25)

Schematic: newMRI_26_08A.kicad_sch

Parts:
C1: JR500HV; CAP-SMD_L3.5-W3.1_V-7586; MPN JR500HV; LCSC Part C20342596
C2, C32, C34: 22u35V; CAP_GMK325B7155MN-T_TAY; LCSC Part C6120016
C3, C25, C26, C27, C35: 15nf; C0402; MPN CC0402JRX7R7BB153; LCSC Part C527002
C5, C6, C7, C8, C31, C36, C40, C41, C42: C1u25v; C0603; MPN CL10B105KA8NNNC; LCSC Part C29936
C9, C19, C20, C21, C1002, C1004, C1005, C1010, C1011, C1012, C1013, C1016, C1018, C1019, C1020, C1021, C1023, C1025, C1027, C1029, C1031, C1033, C1035, C1037, C1039, C1041, C1043, C1047, C1052, C1063, C1064, C1065, C1067, C1068, C1071, C1073, C1075, C1077, C1078, C1079, C1087, C1092, C1093, C1094, C1095, C1097, C1100: 10u25v; C0603; MPN GRM188R61E106KA73D; LCSC Part C344022
C10, C12, C13, C14, C15, C16, C17, C18, C1003, C1006, C1007, C1008, C1009, C1014, C1015, C1017, C1022, C1024, C1026, C1028, C1030, C1032, C1034, C1036, C1038, C1040, C1042, C1044, C1046, C1048, C1050, C1055, C1066, C1070, C1072, C1074, C1076, C1080, C1081, C1082, C1083, C1084, C1085, C1086, C1088, C1089, C1090, C1091, C1096, C1098, C1099, C1109, C1110, C1111, C1112, C1113, C1114, C1115, C1116, C1117, C1118: 0.1u; C0402; MPN CC0402JRX7R9BB104; LCSC Part C5182432
C22, C23, C29, C30: 220PF; C0805; MPN CC0805JRNPOBBN221; LCSC Part C576977
C24, C28: 270pf250V; C0805; MPN 0805CG271J251NT; LCSC Part C20606779; not fitted
C33, C37, C38, C39, C43, C44, C45, C46, C47: 22u35V; CAP_GMK325B7155MN-T_TAY; LCSC Part C6120017
C1001: JR500HV; CAP-SMD_L3.5-W3.1_V-7586; MPN JR500HV; LCSC Part C20342596; not fitted
C1045, C1049, C1051, C1054: 0.1u; C0402; MPN CC0402JRX7R9BB104; LCSC Part C5182432; not fitted
C1053, C1062: 4.7nf; C0402; MPN GRM1555C1H472JE01D; LCSC Part C1518204
C1056, C1057, C1059, C1061: 680pf; C0402; MPN CC0402JRNPO9BN681; LCSC Part C113781
C1058, C1060: 1.5nf; C0603; MPN CC0603JRNPO9BN152; LCSC Part C107039
C1069, C1101: 47pf; C0805; MPN GRM21A5C2E470JW01D; LCSC Part C2179874
C1103, C1104, C1105, C1106: 150pf250V; C0805; MPN TCC0805COG151J251BT; LCSC Part C282715
CN1: 1755765; CONN-TH_1755765; MPN 1755765; LCSC Part C480542
CN2, CN3: DF40C-80DP-0.4V; CONN-SMD_DF40C-80DP-0.4V-51; MPN DF40C-80DP-0.4V(51); LCSC Part C294544
CN4: DF40C-50DP-0.4V; CONN-SMD_DF40C-50DP-0.4V; MPN DF40C-50DP-0.4V(51); LCSC Part C424645
CR1: L79L05; SOIC-8_L5.0-W4.0-P1.27-LS6.0-BL; LCSC Part C2802525
D1, D3, D1001, D1002, D1003, D1004: DIO15A; POWERDI-5_L5.4-W4.0-LS6.5-RD; MPN SBRT15U50SP5-13; LCSC Part C211388
D2, D4, D5, D6, D7, D8, D9, D10, D11, D12, D13, D14, D15, D16, D17, D18: DIOS3A; SMA_L4.3-W2.6-LS5.2-RD; MPN SK36A-LTP; LCSC Part C106867
J1, J4: H3161-05; HARWIN_H3161-05; PARTREV 20; LCSC Part C17274599
J2, J3: H3161-05; HARWIN_H3161-05; PARTREV 20; LCSC Part C17274599; not fitted
L2, L3: Ferrite; L0805; MPN MPZ2012S221AT000; LCSC Part C76818
L1002, L1003: NLCV32T-150K-EF; IND-SMD_L3.2-W2.5; MPN NLCV32T-150K-EF; LCSC Part C250232; not fitted
L1004, L1005: NLCV32T-150K-EF; IND-SMD_L3.2-W2.5; MPN NLCV32T-150K-EF; LCSC Part C250232
L1008, L1009: 820nh; L_1210_3225Metric; MPN NLV32T-R82J-EF; LCSC Part C295116
L1010, L1012, L1013, L1014: 1.8uh; L_1210_3225Metric; MPN NLV32T-1R8J-PF; LCSC Part C41039
R1, R12: 355033RJT; RES_3550_TEC; LCSC Part C4048132
R2, R9, R10, R11: 2R6W; RES_3560_TEC; LCSC Part C2096258
R3, R4, R5, R6, R7, R8: 0.05,1W; RC1206N_VIS; LCSC Part C2073508
R15, R16: 220; R0402; MPN 0402WGF2200TCE; LCSC Part C25091
R17, R18, R19: 49.9; R0402; MPN RMC040249.91%N; LCSC Part C325388
R1001, R1005, R1007, R1009, R1010, R1011, R1012, R1013, R1016, R1017, R1018, R1021, R1026, R1027, R1028, R1033: 10K; R0402; MPN CRCW040210K0FKED; LCSC Part C71617
R1002, R1003, R1019, R1020: FBF25FP-R250; R2512; MPN FBF25FP-R250; LCSC Part C395975
R1004, R1043: 4K7; R0402; MPN RC0402FR-074K7L; LCSC Part C105871
R1006, R1015, R1029, R1030: 4K7; R0402; MPN RC0402FR-074K7L; LCSC Part C105871; not fitted
R1008, R1014, R1022, R1023, R1024, R1025, R1031, R1032, R1034, R1044, R1045, R1047, R1048, R1049: 1K5; R0402; MPN RC0402FR-071K5L; LCSC Part C114759
R1035, R1036, R1037, R1038, R1039, R1040, R1041, R1042: 0402WGF1501TCE; R0402; MPN 0402WGF1501TCE; LCSC Part C25867
RF1, RF2, RF1001: 5-1814832-2; SMA-TH_5-1814832-2; MPN 5-1814832-2; LCSC Part C482015
U1, U4, U8: AD8274ARMZ; RM_8_ADI-L
U2: AFE5808AZCF; BGA-135_L15.0-W9.0-R15-C9-P1.00-BL; MPN AFE5808AZCF; LCSC Part C528615
U3: MAX14808ETK+T; 21-0142E_T6800-4_MXM-L; LCSC Part C2156340
U5, U6: X6511FV-24-C85D32; HDR-TH_24P-P2.54-V-F; MPN X6511FV-24-C85D32; LCSC Part C2883741
U7, U9, U10, U1001, U1002, U1003: OPA548FKTWT; KTW0007A; LCSC Part C2687965
U13, U1004, U1005, U1006: PHA-13LN+; SOT-89-3_L4.5-W2.5-P1.50-LS4.2-BR; MPN PHA-13LN+; LCSC Part C3008204
U14: TPS7A2118PQWDSGRQ1; WSON-8_L2.0-W2.0-P0.50-TL-EP; MPN TPS7A2118PQWDSGRQ1; LCSC Part C41487852
U15, U19: TPS7A2133PQWDRBRQ1; DFN-8_L3.0-W3.0-P0.65-BL-EP-2; MPN TPS7A2133PQWDRBRQ1; LCSC Part C21285173
U17: LM78L05; SOIC-8_L4.9-W3.9-P1.27-LS6.0-BL; MPN LM78L05ACMX/NOPB; LCSC Part C373350
U18: DAC7564; PW0016A_N; LCSC Part C2866362
U1007, U1008, U1009, U1010, U1011, U1012: 215307-3; 215307-3_TYC; LCSC Part C239343

Connections:
5VD: C44.2, C45.2, C46.2, C47.2, C1072.2, C1073.1, C1074.2, C1075.1, C1090.2, CN1.3, CN4.36, CN4.38, CN4.40, CN4.42, CN4.44, CN4.46, CN4.48, CN4.50, U6.1, U14.5 (EN), U14.7 (IN), U14.8 (IN), U15.5 (EN), U15.8 (IN)
+5VA: C1040.2, C1041.1, C1042.2, C1043.1, C1046.2, C1047.1, C1050.2, C1052.1, C1063.1, C1087.1, C1091.2, CN1.4, L1002.2, L1003.2, L1004.2, L1005.2, U2.K2 (AVDD_5V)
+15V: C2.1, C32.1, C33.1, C34.1, C1002.2, C1003.2, C1005.2, C1014.2, C1015.2, C1016.2, C1017.2, C1019.2, C1022.2, C1023.2, C1024.2, C1025.2, C1026.2, C1027.2, C1064.1, C1068.2, C1089.2, C1094.2, C1095.2, C1116.1, C1117.1, C1118.1, CN1.1, D3.3 (C), D8.1 (K), D11.1 (K), D15.1 (K), D18.1 (K), U1.7 (VS+), U4.7 (VS+), U7.5 (V+), U7.7 (E_S), U8.7 (VS+), U9.5 (V+), U9.7 (E_S), U10.5 (V+), U10.7 (E_S), U17.8 (VIN), U1001.5 (V+), U1001.7 (E_S), U1002.5 (V+), U1002.7 (E_S), U1003.5 (V+), U1003.7 (E_S)
-15V: C37.2, C38.2, C39.2, C43.2, C1009.2, C1013.1, C1028.2, C1029.2, C1030.2, C1031.2, C1032.2, C1033.2, C1034.2, C1035.2, C1036.2, C1037.2, C1038.2, C1039.2, C1065.1, C1067.2, C1088.2, C1092.2, C1093.2, C1113.2, C1114.2, C1115.2, CN1.2, CR1.2 (VIN), CR1.3 (VIN), CR1.6 (VIN), CR1.7 (VIN), D1.1 (A), D1.2 (A), D7.2 (A), D14.2 (A), D16.2 (A), D17.2 (A), R1005.1, R1007.2, R1010.1, R1016.1, R1017.1, R1026.1, U1.4 (VS-), U4.4 (VS-), U7.4 (V-), U7.8 (TAB), U8.4 (VS-), U9.4 (V-), U9.8 (TAB), U10.4 (V-), U10.8 (TAB), U1001.4 (V-), U1001.8 (TAB), U1002.4 (V-), U1002.8 (TAB), U1003.4 (V-), U1003.8 (TAB)
/1P8A: L3.2, U2.J6 (AVDD_ADC), U2.J7 (AVDD_ADC), U2.K8 (AVDD_ADC), U2.L3 (AVDD_ADC), U2.M1 (AVDD_ADC), U2.M2 (AVDD_ADC)
/1P8D: C1070.2, C1071.1, L3.1, U2.N3 (DVDD), U2.N7 (DVDD), U14.1 (OUT), U14.2 (OUT)
/3A3: CN4.37
/3P3A: L2.2, U2.A1 (AVDD), U2.D8 (AVDD), U2.D9 (AVDD), U2.E8 (AVDD), U2.E9 (AVDD), U2.K1 (AVDD)
/3P3D: C1076.2, C1077.1, L2.1, U15.1 (OUT)
/A10: U5.16, U1007.2, U1007.5
/A11: U5.17, U1010.2, U1010.5
/A12: U5.18, U1008.2, U1008.5
/A13: U5.19, U1009.2, U1009.5
/ACT1: C31.2, U2.B9 (ACT1)
/ACT2: C36.2, U2.B8 (ACT2)
/ACT7: C41.2, U2.B3 (ACT7)
/ACT8: C42.2, U2.B2 (ACT8)
/ADCCLK: R17.1, U6.14
/AR: R1036.1
/BR: R1035.1
/CE: U2.L9 (SEN), U6.21
/CLKP_ADC: R17.2, U2.L1 (CLKP_ADC)
/D2: CN2.54, RF2.5, U5.4
/D3: CN2.55, U5.5
/D4: CN2.57, U5.6
/D5: CN2.58, U5.7
/D6: CN2.60, U5.8
/D7: CN2.27, U5.9
/D8: CN2.26, U5.10
/D9: CN2.24, U5.11
/D10: CN2.23, U5.12
/D11: CN2.21, U5.13
/D12: CN2.20, U5.14
/DACA: U9.1 (VIN+), U18.1 (VOUTA)
/DACB: U18.2 (VOUTB), U1002.1 (VIN+)
/DACC: R1023.1, U18.7 (VOUTC)
/DACD: R1022.1, U18.8 (VOUTD)
/DACDIN: U5.20, U18.11 (DIN)
/DACREF: C1096.2, C1097.2, R1014.1, R1024.1, U18.3 (VREFH_VREFOUT)
/DACSCLK: U5.22, U18.10 (SCLK)
/DD1M: CN2.6, U2.N8 (D1M)
/DD1P: CN2.5, U2.N9 (D1P)
/DD2M: CN2.9, U2.P9 (D2M)
/DD2P: CN2.8, U2.R9 (D2P)
/DD6M: CN2.11, U2.P2 (D6M)
/DD6P: CN2.12, U2.R2 (D6P)
/DD7M: CN2.14, U2.P1 (D7M)
/DD7P: CN2.15, U2.R1 (D7P)
/DD8M: CN2.70, U2.N2 (D8M)
/DD8P: CN2.69, U2.N1 (D8P)
/DDCLKM: CN2.76, U2.P6 (DCLKM)
/DDCLKP: CN2.75, U2.R6 (DCLKP)
/DDFCLKM: CN2.73, U2.P4 (FCLKM)
/DDFCLKP: CN2.72, U2.R4 (FCLKP)
/DINN1: U3.65 (DINN1), U6.11
/DINN2: U3.63 (DINN2), U6.13
/DINN3: U3.61 (DINN3), U6.17
/DINN4: U3.59 (DINN4), U6.19
/DINN5: U3.21 (DINN5), U6.8
/DINN6: U3.23 (DINN6), U6.6
/DINN7: U3.25 (DINN7), U6.4
/DINN8: U3.27 (DINN8), U5.3
/DINP1: U3.66 (DINP1), U6.10
/DINP2: U3.64 (DINP2), U6.12
/DINP3: U3.62 (DINP3), U6.16
/DINP4: U3.60 (DINP4), U6.18
/DINP5: U3.20 (DINP5), U6.9
/DINP6: U3.22 (DINP6), U6.7
/DINP7: U3.24 (DINP7), U6.5
/DINP8: U3.26 (DINP8), U5.2
/GRADA: C40.1, C1098.1, U8.5 (SENSE), U8.6 (OUT)
/GRADB: C41.1, C1083.1, U4.5 (SENSE), U4.6 (OUT)
/GRADC: C42.1, C1084.1, U1.5 (SENSE), U1.6 (OUT)
/LVOUT3: R19.2, U3.3 (LVOUT3)
/LVOUT4: C1062.1, U3.4 (LVOUT4)
/LVOUT5: C1053.1, U3.14 (LVOUT5)
/LVOUT6: R18.2, U3.15 (LVOUT6)
/LVOUT7: C1111.2, U3.16 (LVOUT7)
/LVOUT8: C1112.2, U3.17 (LVOUT8)
/N5VLT: C1006.1, C1012.1, CR1.1 (VOUT), U3.29 (VEE), U3.57 (VEE)
/NSYNC: U5.23, U18.9 (SYNC_N)
/OUT1: C1103.2, R9.2, R1039.2, U3.51 (OUT1)
/OUT2: C1106.2, R10.2, R1042.2, U3.49 (OUT2)
/OUT3/RFA-: C23.2, C28.2, C30.1, C1001.2, J2.1 (1_1), R1021.2, U3.47 (OUT3)
/OUT4: C1101.2, U3.45 (OUT4)
/OUT5: C1069.2, U3.41 (OUT5)
/OUT6/RFB-: C1.2, C22.1, C24.1, C29.2, J1.1 (1_1), R1033.1, U3.39 (OUT6)
/OUT7: C1104.2, R2.2, R1040.2, U3.37 (OUT7)
/OUT8: C1105.2, R11.2, R1041.2, U3.35 (OUT8)
/P3P3: C1007.2, C1011.1, R1038.1, U3.19 (VDD), U3.67 (VDD), U19.1 (OUT)
/P5VLT: C1008.2, C1010.1, C1048.2, C1066.2, U3.28 (VCC), U3.58 (VCC), U17.1 (VOUT), U19.5 (EN), U19.8 (IN)
/RESET: U2.H9 (RESET), U6.24
/RFA: C36.1, C1057.2, C1085.1, RF1001.5
/RFA+: C23.1, C28.1, C1001.1, C1101.1, J3.1 (1_1)
/RFB: C31.1, C1059.2, C1086.1, RF1.5
/RFB+: C1.1, C22.2, C24.2, C1069.1, J4.1 (1_1)
/SCLK: U2.J9 (SCLK), U6.23
/SDATA: U2.K9 (SDATA), U6.22
/SDOUT: U2.M9 (SDOUT), U6.20
/VDD: C1099.2, C1100.2, U5.15, U18.4 (AVDD), U18.12 (IOVDD), U1007.1, U1007.6, U1008.1, U1008.6, U1009.1, U1009.6, U1010.1, U1010.6
/VNNA: C8.1, C9.2, C12.1, C14.1, C1021.1, D4.2 (A), D13.2 (A), D17.1 (K), D1002.1 (A), D1002.2 (A), R1002.2, U3.44 (VNNA), U3.48 (VNNA), U3.52 (VNNA)
/VNNB: C5.1, C15.1, C17.1, C20.2, C1020.2, D6.2 (A), D12.2 (A), D16.1 (K), D1001.1 (A), D1001.2 (A), R1019.2, U3.34 (VNNB), U3.38 (VNNB), U3.42 (VNNB)
/VOPA: R12.1, R1027.1, U7.6 (VO)
/VOPAP: D7.1 (K), D8.2 (A), R12.2, U1012.4
/VOPA_B: R5.1, R6.1, R1034.2, R1049.2, U1.2 (IN-)
/VOPA_B+: R5.2, U1.3 (IN+), U1012.3
/VOPB: R1.1, R1028.1, U1003.6 (VO)
/VOPBP: D11.2 (A), D14.1 (K), R1.2, U1011.6
/VOUT1P: D10.2 (A), D13.1 (K), R9.1, U1012.6
/VOUT1_2: R3.1, R8.1, R1031.2, R1047.2, U8.2 (IN-)
/VOUT1_2+: R3.2, U8.3 (IN+), U1012.1
/VOUT2P: D2.2 (A), D4.1 (K), R10.1, U1011.4
/VOUT7P: D9.2 (A), D12.1 (K), R2.1, U1012.5
/VOUT7_8: R4.1, R7.1, R1032.2, R1048.2, U4.2 (IN-)
/VOUT7_8+: R4.2, U4.3 (IN+), U1012.2
/VOUT8P: D5.2 (A), D6.1 (K), R11.1, U1011.5
/VPPA: C7.1, C10.1, C13.1, C19.2, C1004.2, D2.1 (K), D10.1 (K), D18.2 (A), D1003.3 (C), R1003.2, U3.46 (VPPA), U3.50 (VPPA), U3.54 (VPPA)
/VPPB: C6.1, C16.1, C18.1, C21.2, C1018.2, D5.1 (K), D9.1 (K), D15.2 (A), D1004.3 (C), R1020.2, U3.32 (VPPB), U3.36 (VPPB), U3.40 (VPPB)
GNDREF: C2.2, C3.1, C9.1, C10.2, C12.2, C13.2, C14.2, C15.2, C16.2, C17.2, C18.2, C19.1, C20.1, C21.1, C25.1, C26.1, C27.1, C29.1, C30.2, C32.2, C33.2, C34.2, C35.1, C37.1, C38.1, C39.1, C43.1, C44.1, C45.1, C46.1, C47.1, C1002.1, C1003.1, C1004.1, C1005.1, C1006.2, C1007.1, C1008.1, C1009.1, C1010.2, C1011.2, C1012.2, C1013.2, C1014.1, C1015.1, C1016.1, C1017.1, C1018.1, C1019.1, C1020.1, C1021.2, C1022.1, C1023.1, C1024.1, C1025.1, C1026.1, C1027.1, C1028.1, C1029.1, C1030.1, C1031.1, C1032.1, C1033.1, C1034.1, C1035.1, C1036.1, C1037.1, C1038.1, C1039.1, C1040.1, C1041.2, C1042.1, C1043.2, C1046.1, C1047.2, C1048.1, C1050.1, C1052.2, C1058.2, C1060.2, C1063.2, C1064.2, C1065.2, C1066.1, C1067.1, C1068.1, C1070.1, C1071.2, C1072.1, C1073.2, C1074.1, C1075.2, C1076.1, C1077.2, C1078.2, C1079.2, C1080.1, C1081.1, C1082.1, C1087.2, C1088.1, C1089.1, C1090.1, C1091.1, C1092.1, C1093.1, C1094.1, C1095.1, C1096.1, C1097.1, C1099.1, C1100.1, C1103.1, C1104.1, C1105.1, C1106.1, C1109.1, C1110.1, C1111.1, C1112.1, C1113.1, C1114.1, C1115.1, C1116.2, C1117.2, C1118.2, CN1.5, CN2.1, CN2.4, CN2.7, CN2.10, CN2.13, CN2.16, CN2.19, CN2.22, CN2.25, CN2.28, CN2.31, CN2.34, CN2.37, CN2.40, CN2.41, CN2.44, CN2.47, CN2.50, CN2.53, CN2.56, CN2.59, CN2.62, CN2.65, CN2.68, CN2.71, CN2.74, CN2.77, CN2.80, CN2.81, CN2.82, CN2.83, CN2.84, CN3.81, CN3.82, CN3.83, CN3.84, CN4.24, CN4.26, CN4.28, CN4.30, CN4.32, CN4.34, CN4.51, CN4.52, CN4.53, CN4.54, CR1.5 (GND), D1.3 (C), D3.1 (A), D3.2 (A), D1001.3 (C), D1002.3 (C), D1003.1 (A), D1003.2 (A), D1004.1 (A), D1004.2 (A), L1008.1, L1009.1, R15.2, R16.2, R18.1, R19.1, R1004.1, R1008.1, R1021.1, R1025.1, R1031.1, R1032.1, R1033.2, R1034.1, R1037.1, R1039.1, R1040.1, R1041.1, R1042.1, R1043.1, R1044.2, R1045.1, R1047.1, R1048.1, R1049.1, RF1.1, RF1.2, RF1.3, RF1.4, RF2.1, RF2.2, RF2.3, RF2.4, RF1001.1, RF1001.2, RF1001.3, RF1001.4, U1.1 (REF), U2.C1 (AVSS), U2.D1 (AVSS), U2.D2 (AVSS), U2.D3 (AVSS), U2.D4 (AVSS), U2.D5 (AVSS), U2.D6 (AVSS), U2.D7 (AVSS), U2.E3 (AVSS), U2.E4 (AVSS), U2.E5 (AVSS), U2.E6 (AVSS), U2.E7 (AVSS), U2.F3 (AVSS), U2.F4 (AVSS), U2.F5 (AVSS), U2.F6 (AVSS), U2.F7 (AVSS), U2.G1 (AVSS), U2.G2 (AVSS), U2.G3 (AVSS), U2.G4 (AVSS), U2.G5 (AVSS), U2.G6 (AVSS), U2.G7 (AVSS), U2.H3 (AVSS), U2.H4 (AVSS), U2.H5 (AVSS), U2.H6 (AVSS), U2.H7 (AVSS), U2.H8 (PDN_GLOBAL), U2.J3 (AVSS), U2.J4 (AVSS), U2.J5 (AVSS), U2.J8 (PDN_VCA), U2.K6 (AVSS), U2.L2 (CLKM_ADC), U2.L8 (PDN_ADC), U2.N5 (DVSS), U2.P5 (DVSS), U2.R5 (DVSS), U3.5 (*LDO_EN), U3.7 (SYNC), U3.9 (*CLK), U3.10 (CC0), U3.11 (CC1), U3.13 (MODE1), U3.18 (GND), U3.33 (GND), U3.43 (GND), U3.53 (GND), U3.68 (GND), U3.69 (EPAD), U4.1 (REF), U5.1, U6.2, U6.15, U8.1 (REF), U13.2 (GND), U14.4 (GND), U14.9 (EP), U15.4 (GND), U15.9 (EP), U17.2 (GND), U17.3 (GND), U17.6 (GND), U17.7 (GND), U18.5 (VREFL), U18.6 (GND), U18.13 (A0), U18.14 (A1), U18.15 (ENABLE_N), U18.16 (LDAC), U19.4 (GND), U19.9 (EP), U1004.2 (GND), U1005.2 (GND), U1006.2 (GND), U1007.3, U1007.4, U1008.3, U1008.4, U1009.3, U1009.4, U1010.3, U1010.4
unnamed: C1045.1, R1006.2
unnamed: C1049.1, R1015.2
unnamed: C1051.1, R1030.2
unnamed: C1054.1, R1029.2
unnamed: C1056.2, L1012.1
unnamed: C1057.1, L1010.2
unnamed: C1058.1, L1008.2, L1012.2, L1013.1
unnamed: C1059.1, L1013.2
unnamed: C1060.1, L1009.2, L1010.1, L1014.2
unnamed: C1061.2, L1014.1
unnamed: CN4.12, R1036.2
unnamed: CN4.14, R1035.2
unnamed: R6.2, U1011.1
unnamed: R7.2, U1011.2
unnamed: R8.2, U1011.3
unnamed: C40.2, U2.B4 (ACT6)
unnamed: C1078.1, U2.B1 (CM_BYP)
unnamed: C1080.2, R15.1, U2.K4 (VCNTLM)
unnamed: C1081.2, R16.1, U2.K3 (VCNTLP)
unnamed: C1079.1, U2.K5 (VHIGH)
unnamed: C1082.2, U2.M3 (VREF_IN)
unnamed: C27.2, U2.C9 (INM1)
unnamed: C26.2, U2.C8 (INM2)
unnamed: C35.2, U2.C4 (INM6)
unnamed: C25.2, U2.C3 (INM7)
unnamed: C3.2, U2.C2 (INM8)
unnamed: C1086.2, U2.A9 (INP1)
unnamed: C1085.2, U2.A8 (INP2)
unnamed: C1098.2, U2.A4 (INP6)
unnamed: C1083.2, U2.A3 (INP7)
unnamed: C1084.2, U2.A2 (INP8)
unnamed: R1037.2, U3.8 (CLK)
unnamed: C1109.2, U3.1 (LVOUT1)
unnamed: C1110.2, U3.2 (LVOUT2)
unnamed: R1038.2, U3.12 (MODE0)
unnamed: C8.2, U3.56 (VGNA)
unnamed: C5.2, U3.30 (VGNB)
unnamed: C7.2, U3.55 (VGPA)
unnamed: C6.2, U3.31 (VGPB)
unnamed: R1010.2, U7.3 (ILIM)
unnamed: R1023.2, U7.1 (VIN+)
unnamed: R1024.2, R1027.2, R1044.1, U7.2 (VIN-)
unnamed: R1005.2, U9.3 (ILIM)
unnamed: R1011.1, R1045.2, U9.2 (VIN-)
unnamed: R1003.1, R1011.2, R1012.1, U9.6 (VO)
unnamed: R1007.1, U10.3 (ILIM)
unnamed: R1043.2, U10.1 (VIN+)
unnamed: R1012.2, R1013.2, U10.2 (VIN-)
unnamed: R1002.1, R1013.1, U10.6 (VO)
unnamed: C1055.2, R1030.1, U13.1 (RF-IN)
unnamed: C1051.2, C1056.1, L1004.1, U13.3 (RF-OUT&DC-IN)
unnamed: R1017.2, U1001.3 (ILIM)
unnamed: R1004.2, U1001.1 (VIN+)
unnamed: R1001.2, R1018.2, U1001.2 (VIN-)
unnamed: R1018.1, R1019.1, U1001.6 (VO)
unnamed: R1016.2, U1002.3 (ILIM)
unnamed: R1008.2, R1009.1, U1002.2 (VIN-)
unnamed: R1001.1, R1009.2, R1020.1, U1002.6 (VO)
unnamed: R1026.2, U1003.3 (ILIM)
unnamed: R1022.2, U1003.1 (VIN+)
unnamed: R1014.2, R1025.2, R1028.2, U1003.2 (VIN-)
unnamed: C1044.2, R1006.1, U1004.1 (RF-IN)
unnamed: C1045.2, C1061.1, L1002.1, U1004.3 (RF-OUT&DC-IN)
unnamed: C1062.2, R1015.1, U1005.1 (RF-IN)
unnamed: C1044.1, C1049.2, L1003.1, U1005.3 (RF-OUT&DC-IN)
unnamed: C1053.2, R1029.1, U1006.1 (RF-IN)
unnamed: C1054.2, C1055.1, L1005.1, U1006.3 (RF-OUT&DC-IN)

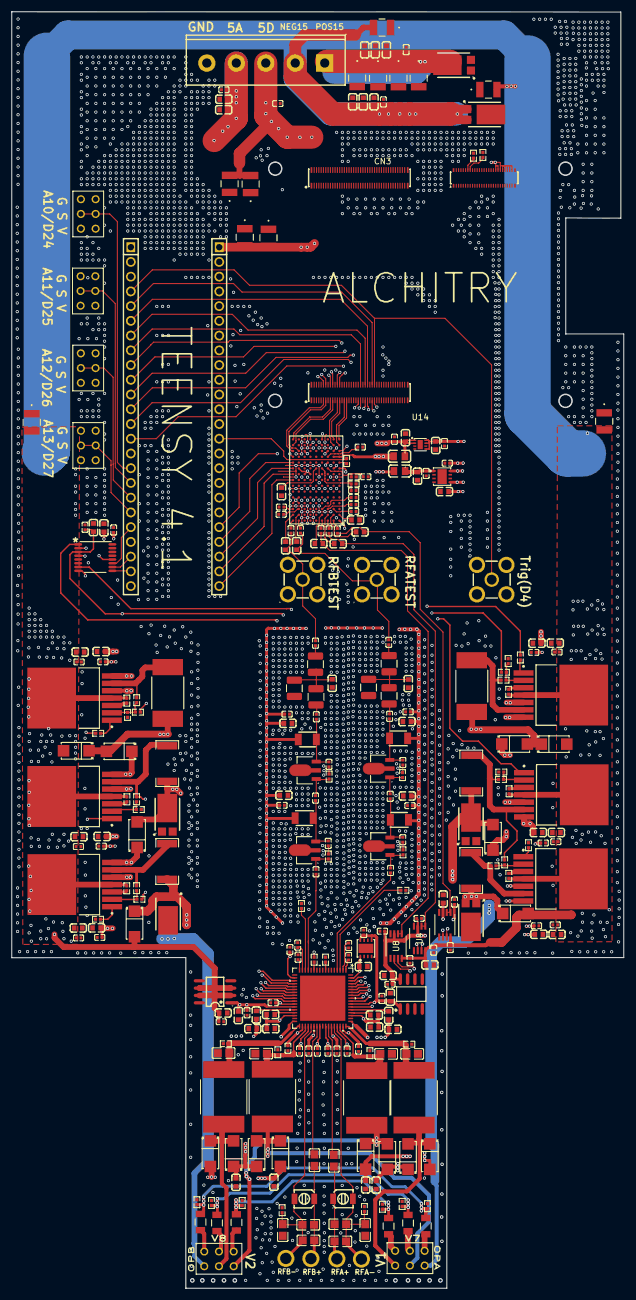
[picture p54: board newMRI_26_08A.kicad_pcb from above]

Board: 4 copper layers, 105.5 x 220.0 mm, 299 parts (0 on the bottom side), 183 nets.
