MIT-HandHeldMRI/HandHeldMRI/Teensy Code/DitheredPulses/SE_MAX14808_POTZ_7_26Brd/dac_defs_10bit.h

// DAC Definitions (10-bit) - generated!!!!!!!!!!!!!!!!!!!!!!!!!!!!
// Each D#### expands to 10 tokens, MSB first: bit=1 -> DAC1, bit=0 -> DAC0

#define D0000 DAC0 DAC0 DAC0 DAC0 DAC0 DAC0 DAC0 DAC0 DAC0 DAC0
#define D0001 DAC0 DAC0 DAC0 DAC0 DAC0 DAC0 DAC0 DAC0 DAC0 DAC1
#define D0002 DAC0 DAC0 DAC0 DAC0 DAC0 DAC0 DAC0 DAC0 DAC1 DAC0
#define D0003 DAC0 DAC0 DAC0 DAC0 DAC0 DAC0 DAC0 DAC0 DAC1 DAC1
#define D0004 DAC0 DAC0 DAC0 DAC0 DAC0 DAC0 DAC0 DAC1 DAC0 DAC0
#define D0005 DAC0 DAC0 DAC0 DAC0 DAC0 DAC0 DAC0 DAC1 DAC0 DAC1
#define D0006 DAC0 DAC0 DAC0 DAC0 DAC0 DAC0 DAC0 DAC1 DAC1 DAC0
#define D0007 DAC0 DAC0 DAC0 DAC0 DAC0 DAC0 DAC0 DAC1 DAC1 DAC1
#define D0008 DAC0 DAC0 DAC0 DAC0 DAC0 DAC0 DAC1 DAC0 DAC0 DAC0
#define D0009 DAC0 DAC0 DAC0 DAC0 DAC0 DAC0 DAC1 DAC0 DAC0 DAC1
#define D0010 DAC0 DAC0 DAC0 DAC0 DAC0 DAC0 DAC1 DAC0 DAC1 DAC0
#define D0011 DAC0 DAC0 DAC0 DAC0 DAC0 DAC0 DAC1 DAC0 DAC1 DAC1
#define D0012 DAC0 DAC0 DAC0 DAC0 DAC0 DAC0 DAC1 DAC1 DAC0 DAC0
#define D0013 DAC0 DAC0 DAC0 DAC0 DAC0 DAC0 DAC1 DAC1 DAC0 DAC1
#define D0014 DAC0 DAC0 DAC0 DAC0 DAC0 DAC0 DAC1 DAC1 DAC1 DAC0
#define D0015 DAC0 DAC0 DAC0 DAC0 DAC0 DAC0 DAC1 DAC1 DAC1 DAC1
#define D0016 DAC0 DAC0 DAC0 DAC0 DAC0 DAC1 DAC0 DAC0 DAC0 DAC0
#define D0017 DAC0 DAC0 DAC0 DAC0 DAC0 DAC1 DAC0 DAC0 DAC0 DAC1
#define D0018 DAC0 DAC0 DAC0 DAC0 DAC0 DAC1 DAC0 DAC0 DAC1 DAC0
#define D0019 DAC0 DAC0 DAC0 DAC0 DAC0 DAC1 DAC0 DAC0 DAC1 DAC1
#define D0020 DAC0 DAC0 DAC0 DAC0 DAC0 DAC1 DAC0 DAC1 DAC0 DAC0
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
    case 992: D0992 break; \
    case 993: D0993 break; \
    case 994: D0994 break; \
    case 995: D0995 break; \
    case 996: D0996 break; \
    case 997: D0997 break; \
    case 998: D0998 break; \
    case 999: D0999 break; \
    case 1000: D1000 break; \
    case 1001: D1001 break; \
    case 1002: D1002 break; \
    case 1003: D1003 break; \
    case 1004: D1004 break; \
    case 1005: D1005 break; \
    case 1006: D1006 break; \
    case 1007: D1007 break; \
    case 1008: D1008 break; \
    case 1009: D1009 break; \
    case 1010: D1010 break; \
    case 1011: D1011 break; \
    case 1012: D1012 break; \
    case 1013: D1013 break; \
    case 1014: D1014 break; \
    case 1015: D1015 break; \
    case 1016: D1016 break; \
    case 1017: D1017 break; \
    case 1018: D1018 break; \
    case 1019: D1019 break; \
    case 1020: D1020 break; \
    case 1021: D1021 break; \
    case 1022: D1022 break; \
    case 1023: D1023 break; \
    default: D1023 break; \
  }
