MIT-HandHeldMRI/HandHeldMRI/Teensy Code/DitheredPulses/SE_MAX14808_POTZ_7_26Brd/dac_defs_6bit.h

// T4.1 Dvals  to GPIO8, D28:GPIO8->->30, GPIO8->31
// DACS:Start DAC Message, DACE:End DAC Message,
#define DACE \
  GPIO8_DR = 0x00400000; \
  GPIO8_DR = 0x00400000; \
  GPIO8_DR = 0x00400000; \
  GPIO8_DR = 0x00400000; \
  GPIO8_DR = 0x00400000; \
  GPIO8_DR = 0x00400000; \
  GPIO8_DR = 0x00400000; \
  GPIO8_DR = 0x00400000; \
  GPIO8_DR = 0x00400000; \
  GPIO8_DR = 0x00400000; \
  GPIO8_DR = 0x00400000; \
  GPIO8_DR = 0x00400000; \
  GPIO8_DR = 0x00400000; \
  GPIO8_DR = 0x00400000; \
  GPIO8_DR = 0x00400000; \
  GPIO8_DR = 0x00400000; \
  GPIO8_DR = 0x00400000; \
  GPIO8_DR = 0x00400000; \
  GPIO8_DR = 0x00400000; \
  GPIO8_DR = 0x00400000; \
  GPIO8_DR = 0x00400000; \
  GPIO8_DR = 0x00400000; \
  GPIO8_DR = 0x00400000; \
  GPIO8_DR = 0x00400000; \
  GPIO8_DR = 0x00400000; \
  GPIO8_DR = 0x00400000; \
  GPIO8_DR = 0x00400000; \
  GPIO8_DR = 0x00400000; \
  GPIO8_DR = 0x00400000; \
  GPIO8_DR = 0x00400000; \
  GPIO8_DR = 0x00400000; \
  GPIO8_DR = 0x00400000; \
  GPIO8_DR = 0x00400000; \
  GPIO8_DR = 0x00400000; \
  GPIO8_DR = 0x00400000; \
  GPIO8_DR = 0x00400000; \
  GPIO8_DR = 0x00400000; \
  GPIO8_DR = 0x00400000; \
  GPIO8_DR = 0x00400000; \
  GPIO8_DR = 0x00400000; \
  GPIO8_DR = 0x00400000; \
  GPIO8_DR = 0x00400000; \
  GPIO8_DR = 0x00400000; \
  GPIO8_DR = 0x00400000; \
  GPIO8_DR = 0x00400000; \
  GPIO8_DR = 0x00400000; \
  GPIO8_DR = 0x00400000; \
  GPIO8_DR = 0x00400000;

#define DACS \
  GPIO8_DR = 0x00000000; \
  GPIO8_DR = 0x00000000; \
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
#define DACB DAC0 DAC0 DAC1 DAC0
#define DACC DAC0 DAC1 DAC0 DAC0
#define DACD DAC0 DAC1 DAC1 DAC0

// SETA controls channels 1-4, SETB 5-8, DACC and DACD control opamps
#define SETA DACS CMD DACA
#define SETB DACS CMD DACB
#define SETC DACS CMD DACC
#define SETD DACS CMD DACD
