MIT-HandHeldMRI/HandHeldMRI/Teensy Code/DitheredPulses/SE_MAX14808_POTZ_7_26Brd/dac_defs_7bit.h

// 7-bit DAC resolution (128 levels). Word = level * 2, sent MSB first.
// T4.1 Dvals  to GPIO8, D28:GPIO8->->30, GPIO8->31
// DACS:Start DAC Message, DACE:End DAC Message,
#define DACE \
  GPIO8_DR = 0x00400000; \
  GPIO8_DR = 0x00400000; \
  GPIO8_DR = 0x00400000; \
  GPIO8_DR = 0x00400000; \
  GPIO8_DR = 0x00400000; \
  GPIO8_DR = 0x00400000; \
  GPIO8_DR = 0x00400000; \
  GPIO8_DR = 0x00400000; \
  GPIO8_DR = 0x00400000; \
  GPIO8_DR = 0x00400000; \
  GPIO8_DR = 0x00400000; \
  GPIO8_DR = 0x00400000; \
  GPIO8_DR = 0x00400000; \
  GPIO8_DR = 0x00400000; \
  GPIO8_DR = 0x00400000; \
  GPIO8_DR = 0x00400000; \
  GPIO8_DR = 0x00400000; \
  GPIO8_DR = 0x00400000; \
  GPIO8_DR = 0x00400000; \
  GPIO8_DR = 0x00400000; \
  GPIO8_DR = 0x00400000; \
  GPIO8_DR = 0x00400000; \
  GPIO8_DR = 0x00400000; \
  GPIO8_DR = 0x00400000; \
  GPIO8_DR = 0x00400000; \
  GPIO8_DR = 0x00400000; \
  GPIO8_DR = 0x00400000; \
  GPIO8_DR = 0x00400000; \
  GPIO8_DR = 0x00400000; \
  GPIO8_DR = 0x00400000; \
  GPIO8_DR = 0x00400000; \
  GPIO8_DR = 0x00400000; \
  GPIO8_DR = 0x00400000; \
  GPIO8_DR = 0x00400000; \
  GPIO8_DR = 0x00400000; \
  GPIO8_DR = 0x00400000; \
  GPIO8_DR = 0x00400000; \
  GPIO8_DR = 0x00400000; \
  GPIO8_DR = 0x00400000; \
  GPIO8_DR = 0x00400000; \
  GPIO8_DR = 0x00400000; \
  GPIO8_DR = 0x00400000; \
  GPIO8_DR = 0x00400000; \
  GPIO8_DR = 0x00400000; \
  GPIO8_DR = 0x00400000; \
  GPIO8_DR = 0x00400000; \
  GPIO8_DR = 0x00400000; \
  GPIO8_DR = 0x00400000;

#define DACS \
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
    case 99: D198 break; \
    case 100: D200 break; \
    case 101: D202 break; \
    case 102: D204 break; \
    case 103: D206 break; \
    case 104: D208 break; \
    case 105: D210 break; \
    case 106: D212 break; \
    case 107: D214 break; \
    case 108: D216 break; \
    case 109: D218 break; \
    case 110: D220 break; \
    case 111: D222 break; \
    case 112: D224 break; \
    case 113: D226 break; \
    case 114: D228 break; \
    case 115: D230 break; \
    case 116: D232 break; \
    case 117: D234 break; \
    case 118: D236 break; \
    case 119: D238 break; \
    case 120: D240 break; \
    case 121: D242 break; \
    case 122: D244 break; \
    case 123: D246 break; \
    case 124: D248 break; \
    case 125: D250 break; \
    case 126: D252 break; \
    case 127: D254 break; \
    default: D255 break; \
  }

// Completion of 12 bits, plus don't care four bits and end.
#define ENDM DAC0 DAC0 DAC1 DAC1 DAC1 DAC1 DAC1 DAC1 DACE

// 8 Bits to start: setting command, DAC:A,B,C,D
#define CMD  DAC0 DAC0 DAC0 DAC1
#define DACA DAC0 DAC0 DAC0 DAC0
#define DACB DAC0 DAC0 DAC1 DAC0
#define DACC DAC0 DAC1 DAC0 DAC0
#define DACD DAC0 DAC1 DAC1 DAC0

// SETA controls channels 1-4, SETB 5-8, DACC and DACD control opamps
#define SETA DACS CMD DACA
#define SETB DACS CMD DACB
#define SETC DACS CMD DACC
#define SETD DACS CMD DACD
