MIT-HandHeldMRI/HandHeldMRI/Teensy Code/DitheredPulses/SE_MAX14808_POTZ_7_26Brd/4149.h

UW UW UW UW UW UW UW UW UW UW UW UW UW UW UW UW UW UW UW UW UW UW UW UW UW UW UW UW UW UW UW UW UW 
DW DW DW DW DW DW DW DW DW DW DW DW DW DW DW DW DW DW DW DW DW DW DW DW DW DW DW DW DW DW DW DW DW 
UW UW UW UW UW UW UW UW UW UW UW UW UW UW UW UW UW UW UW UW UW UW UW UW UW UW UW UW UW UW UW UW UW 
DW DW DW DW DW DW DW DW DW DW DW DW DW DW DW DW DW DW DW DW DW DW DW DW DW DW DW DW DW DW DW DW DW 
UW UW UW UW UW UW UW UW UW UW UW UW UW UW UW UW UW UW UW UW UW UW UW UW UW UW UW UW UW UW UW UW UW 
DW DW DW DW DW DW DW DW DW DW DW DW DW DW DW DW DW DW DW DW DW DW DW DW DW DW DW DW DW DW DW DW DW 
UW UW UW UW UW UW UW UW UW UW UW UW UW UW UW UW UW UW UW UW UW UW UW UW UW UW UW UW UW UW UW UW UW UW UW UW 
DW DW DW DW DW DW DW DW DW DW DW DW DW DW DW DW DW DW DW DW DW DW DW DW DW DW DW DW DW DW DW 
UW UW UW UW UW UW UW UW UW UW UW UW UW UW UW UW UW UW UW UW UW UW UW UW UW UW UW UW UW UW UW UW UW UW UW 
DW DW DW DW DW DW DW DW DW DW DW DW DW DW DW DW DW DW DW DW DW DW DW DW DW DW DW DW DW DW DW 
UW UW UW UW UW UW UW UW UW UW UW UW UW UW UW UW UW UW UW UW UW UW UW UW UW UW UW UW UW UW UW UW UW UW UW UW 
DW DW DW DW DW DW DW DW DW DW DW DW DW DW DW DW DW DW DW DW DW DW DW DW DW DW DW DW DW DW DW DW 
UW UW UW UW UW UW UW UW UW UW UW UW UW UW UW UW UW UW UW UW UW UW UW UW UW UW UW UW UW UW UW UW UW 
DW DW DW DW DW DW DW DW DW DW DW DW DW DW DW DW DW DW DW DW DW DW DW DW DW DW DW DW DW DW DW DW DW 
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
UW UW UW UW UW UW UW UW UW UW UW UW UW UW UW UW UW UW UW UW UW UW UW UW UW UW UW UW UW UW UW UW UW UW UW UW 
DW DW DW DW DW DW DW DW DW DW DW DW DW DW DW DW DW DW DW DW DW DW DW DW DW DW DW DW DW DW DW DW 
