MIT-HandHeldMRI/HandHeldMRI/Teensy Code/FlipAngleCal/teensymri.h

// teensymri.h
#include <stdint.h>
#pragma once

extern "C" uint32_t set_arm_clock(uint32_t frequency); //These lines may not be necessary?
#define ARM_CLOCK_FREQ 600000000

#define NOP_PIN 29
#define READOUT 30

// MAx14808 Control Pins not used!!
// #define MODE1 31
// #define MODE0 32

#define STARTSEQ0 0
#define STARTSEQ1 1

// Teensy to gpio6 bit map corrected 7/26/24
// Teensy Pin numbers start from Top right= 1, Top left = 48
// gpio6 bit         |31|30|29|28| |27|26|25|24| |23|22|21|20| |19|18|17|16|
// Teensy4.1 Dbit    |27|26|39|38| |21|20|23|22| |16|17|41|40| |15|14|18|19|
// Teensy4.1 Pin     |31|30|18|19| |06|07|04|05| |11|10|16|17| |12|13|09|08|
// Eval Max14808     |P5|N5|P4|N4| |P7|N7|P6|N6| |N1|P1|P3|N3| |P2|N2|N8|P8|

// gpio6 bit      |15|14|13|12| |11|10|09|08| |07|06|05|04| |03|02|01|00|
// Teensy4.1 Dbit |--|--|25|24| |--|--|--|--| |--|--|--|--| | 0| 1|--|--|
//
 

// RF Driver Up, Down, Clamped, Through for Max14808 7+8
#define UP  GPIO6_DR = 0x08020000;  // N7=P8=0 P7=N8=1
#define DN  GPIO6_DR = 0x04010000;  // N7=P8=1 P7=N8=0
#define ZZ  GPIO6_DR &= ~(0x08020000 | 0x04010000);  // TR8, TR7 Clamped
#define ZT  GPIO6_DR = 0x0C000000;
#define TR  ZZ GPIO6_DR |= 0x00030000;  // TR8 Thru, TR7 Clamped

#define CLAMP ZZ
#define RELEASE TR

// RF Driver Up, Down, Clamped, Through for Max14808 5+6
// #define UP  GPIO6_DR = 0x81000000;  // N5=P6=0 P5=N6=1
// #define DN  GPIO6_DR = 0x42000000;  // N5=P6=1 P5=N6=0
// #define ZZ  GPIO6_DR = 0x00000000;  // TR5, TR6 Clamped
// #define ZT  GPIO6_DR = 0x00000000;
// #define TR  GPIO6_DR = 0x03000000;  // TR6 Thru, TR5 Clamped

// Gradients using Max14808 1+3 for Z axis coil pair, 2+4 for Y.
/* Z grad on 1 and 2 */
#define YGP GPIO6_DR =  0x20070000;  // P4=N3=1 P7,8=TR
#define YGN GPIO6_DR =  0x100B0000;  // N4=P3=1 P7,8=TR

#define ZGP GPIO6_DR =  0x00930000;  // N1=P3=1 
#define ZGN GPIO6_DR =  0x00630000;  // P1=N3=1 

/*
#define YZGN GPIO6_DR = 0x91230000;  // N4=N6=P3=P5=1 PGrad
#define YZGP GPIO6_DR = 0x62130000;  // P4=P6=N3=N5=1 NGrad
*/

#define UW UP // For the include file RF pulse.
#define DW DN

#define UP21 UP UP UP UP UP UP UP UP  UP UP UP UP UP UP UP UP  UP UP UP UP UP  
#define DN21 DN DN DN DN DN DN DN DN  DN DN DN DN DN DN DN DN  DN DN DN DN DN 
#define ZZ40 ZZ ZZ ZZ ZZ  ZZ ZZ ZZ ZZ  ZZ ZZ ZZ ZZ  ZZ ZZ ZZ ZZ  ZZ ZZ ZZ ZZ  ZZ ZZ ZZ ZZ  ZZ ZZ ZZ ZZ  ZZ ZZ ZZ ZZ  ZZ ZZ ZZ ZZ  ZZ ZZ ZZ ZZ
#define ZZ800 ZZ40 ZZ40 ZZ40 ZZ40 ZZ40 ZZ40 ZZ40 ZZ40  ZZ40 ZZ40 ZZ40 ZZ40  ZZ40 ZZ40 ZZ40 ZZ40 ZZ40 ZZ40 ZZ40 ZZ40
#define CLAMP_STD ZZ800 ZZ800 ZZ800 ZZ800 ZZ800
#define ZT40 ZT ZT ZT ZT  ZT ZT ZT ZT  ZT ZT ZT ZT  ZT ZT ZT ZT  ZT ZT ZT ZT  ZT ZT ZT ZT  ZT ZT ZT ZT  ZT ZT ZT ZT  ZT ZT ZT ZT  ZT ZT ZT ZT
#define ZT800 ZT40 ZT40 ZT40 ZT40 ZT40 ZT40 ZT40 ZT40  ZT40 ZT40 ZT40 ZT40  ZT40 ZT40 ZT40 ZT40 ZT40 ZT40 ZT40 ZT40
#define CLAMP_STD_T ZT800 ZT800 ZT800 ZT800
// #define CLAMP ZZ800 // CLAMP_STD_T CLAMP_STD_T //CLAMP_STD_T CLAMP5//ZZ800 ZZ800 ZZ800 ZZ800 //ZZ800 //CLAMP5 //CLAMP5 C////LAMP5 //CLAMP5 //ZZ800 ZZ800 ZZ800 ZZ800 //CLAMP5 //CLAMP5 //CLAMP5

#define TR40 TR TR TR TR  TR TR TR TR  TR TR TR TR  TR TR TR TR  TR TR TR TR  TR TR TR TR  TR TR TR TR  TR TR TR TR  TR TR TR TR  TR TR TR TR 
#define TR82 TR40 TR40 TR40 TR40   TR40 TR40 TR40 TR40  TR40 TR40 TR40 TR40  TR40 TR40 TR40 TR40  TR40 TR40 TR40 TR40
#define TR83 TR82 TR82 TR82 TR82 TR82 TR82 TR82 TR82 TR82 TR82 

#define ZGN10 ZGN ZGN ZGN ZGN  ZGN ZGN ZGN ZGN  ZGN ZGN 
#define ZGN100 ZGN10 ZGN10 ZGN10 ZGN10  ZGN10 ZGN10 ZGN10 ZGN10 ZGN10 ZGN10
#define ZGN82 ZGN100 ZGN100 ZGN100 ZGN100  ZGN100 ZGN100 ZGN100 ZGN100 
#define ZGN83 ZGN82 ZGN82 ZGN82 ZGN82 ZGN82 ZGN82 ZGN82 ZGN82 ZGN82 ZGN82 

#define ZGP10 ZGP ZGP ZGP ZGP  ZGP ZGP ZGP ZGP  ZGP ZGP 
#define ZGP100 ZGP10 ZGP10 ZGP10 ZGP10  ZGP10 ZGP10 ZGP10 ZGP10 ZGP10 ZGP10
#define ZGP82 ZGP100 ZGP100 ZGP100 ZGP100 ZGP100 ZGP100 ZGP100 ZGP100 
#define ZGP83 ZGP82 ZGP82 ZGP82 ZGP82 ZGP82 ZGP82 ZGP82 ZGP82 ZGP82 ZGP82 

#define YGP10 YGP YGP YGP YGP   YGP YGP YGP YGP  YGP YGP  
#define YGP100 YGP10 YGP10 YGP10 YGP10  YGP10 YGP10 YGP10 YGP10 YGP10 YGP10
#define YGP82 YGP100 YGP100 YGP100 YGP100 YGP100 YGP100 YGP100 YGP100 
#define YGP83 YGP82 YGP82 YGP82 YGP82 YGP82 YGP82 YGP82 YGP82 YGP82 YGP82 

#define YGN10 YGN YGN YGN YGN  YGN YGN YGN YGN  YGN YGN 
#define YGN100 YGN10 YGN10 YGN10 YGN10  YGN10 YGN10 YGN10 YGN10 YGN10 YGN10
#define YGN82 YGN100 YGN100 YGN100 YGN100 YGN100 YGN100 YGN100 YGN100 
#define YGN83 YGN82 YGN82 YGN82 YGN82 YGN82 YGN82 YGN82 YGN82 YGN82 YGN82 
/*
#define YZGP10 YZGP YZGP YZGP YZGP  YZGP YZGP YZGP YZGP  YZGP YZGP  
#define YZGP100 YZGP10 YZGP10 YZGP10 YZGP10  YZGP10 YZGP10 YZGP10 YZGP10 YZGP10 YZGP10
#define YZGP82 YZGP100 YZGP100 YZGP100 YZGP100 YZGP100 YZGP100 YZGP100 YZGP100 
#define YZGP83 YZGP82 YZGP82 YZGP82 YZGP82 YZGP82 YZGP82 YZGP82 YZGP82 YZGP82 YZGP82 

#define YZGN10 YZGN YZGN YZGN YZGN  YZGN YZGN YZGN YZGN  YZGN YZGN 
#define YZGN100 YZGN10 YZGN10 YZGN10 YZGN10  YZGN10 YZGN10 YZGN10 YZGN10 YZGN10 YZGN10
#define YZGN82 YZGN100 YZGN100 YZGN100 YZGN100 YZGN100 YZGN100 YZGN100 YZGN100 
#define YZGN83 YZGN82 YZGN82 YZGN82 YZGN82 YZGN82 YZGN82 YZGN82 YZGN82 YZGN82 YZGN82 
*/
// 6.9mhz->43.5 periods, so alternate betwween 44 and 43, with with four periods to give equal time up and down.
#define PER4 UP21 UP DN21 DN  UP21 DN21 DN  UP21 UP DN21 DN  UP21 UP DN21 // 22U,22D, 21U,22D, 22U,22D, 22U,21D
#define PER8 PER4 PER4
#define PER16 PER8 PER8
#define PER32 PER16 PER16
#define PER64 PER32 PER32
#define PER128 PER64 PER64
#define PER256 PER128 PER128
#define PER512 PER256 PER256


#define NOP digitalWriteFast(NOP_PIN, false);
#define NOP40 NOP NOP NOP NOP NOP NOP NOP NOP NOP NOP NOP NOP NOP NOP NOP NOP NOP NOP NOP NOP NOP NOP NOP NOP NOP NOP NOP NOP NOP NOP NOP NOP NOP NOP NOP NOP NOP NOP NOP NOP
#define NOP800  NOP40 NOP40 NOP40 NOP40  NOP40 NOP40 NOP40 NOP40  NOP40 NOP40 NOP40 NOP40  NOP40 NOP40 NOP40 NOP40  NOP40 NOP40 NOP40 NOP40  

#define SEHALF 60

#define GR_X 0
#define GR_Y 1
#define GR_Z 2

#define GR_POS 1
#define GR_NEG -1
#define GR_OFF 0

const uint8_t AFE_RESET = 6;
const uint8_t AFE_SCK_PIN = 7;
const uint8_t AFE_MOSI_PIN = 8;
const uint8_t AFE_CE_PIN = 9;
const uint8_t AFE_MISO_PIN = 10;

void AFE_setup();
void spi_write(uint8_t data_pin, uint8_t clock_pin, uint32_t freq, uint8_t bit_order, uint8_t mode, uint8_t bits, uint32_t val_out);
void initCycleCounter();
void generatePulses(float freq, uint32_t duration_us);
void GPIO_setup();
void gradient(uint8_t gradient, int8_t pol);
void set_gradient_amplitude(uint16_t amplitude);
void set_rf_amplitude(uint16_t amplitude);
