MIT-HandHeldMRI/HandHeldMRI/(commit log)

2026-10-25 Add files from Fall 2025
    [assembly.blend, mri25BoardSupport.stl, mri25Cam3p28w.stl, mri25Cam3p76w.stl, mri25Cam4p22w.stl, mri25MagConeS.stl, mri25MagRing8.stl, mri25RfCoilForm.stl]
2026-10-25 Add KiCAD Project and Dithered Pulses
    [newMRI_26_08A.kicad_pcb, newMRI_26_08A.kicad_sch]
2026-11-03 Update new magnet files from Jacob
    [coneMRIxy.stl, magRing.stl, mri25BoardSupport.stl, mri25Cam3p28w.stl, mri25Cam3p76w.stl, mri25Cam4p22w.stl, mri25MagConeS.stl, mri25MagHolder.stl]
